carlmegens/knekelbeen/case/base_left.png

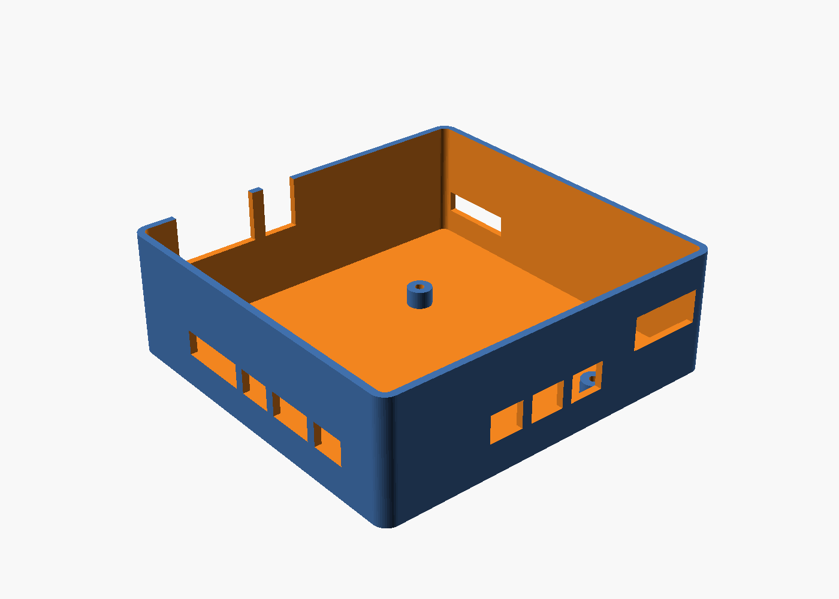
case/base_left.png
