carlmegens/knekelbeen/case/base_top.png

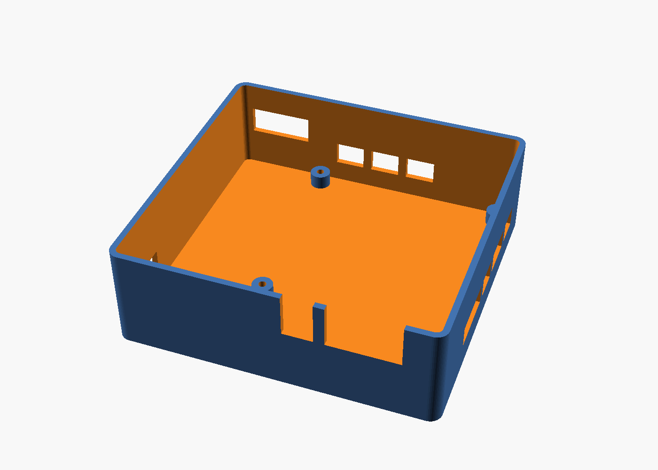
case/base_top.png
