carlmegens/knekelbeen/case/lid_view.png

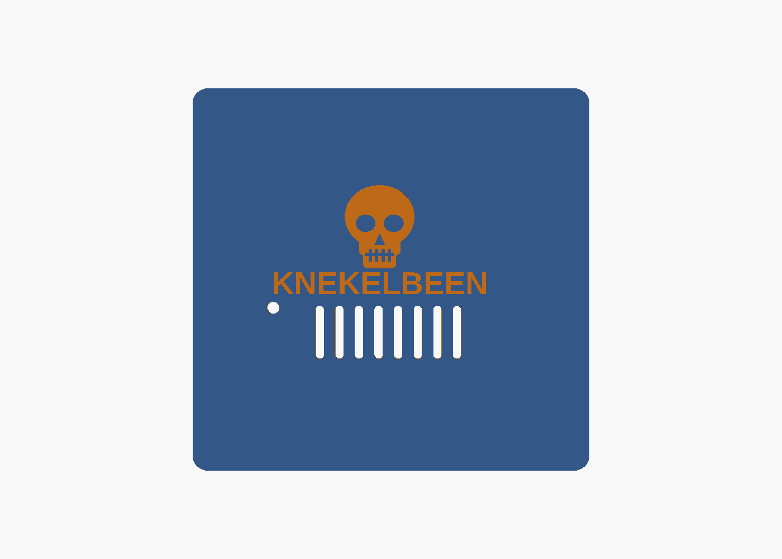
case/lid_view.png
