carlmegens/knekelbeen/kaarsen/Kaarsen_zonder_support_details.png

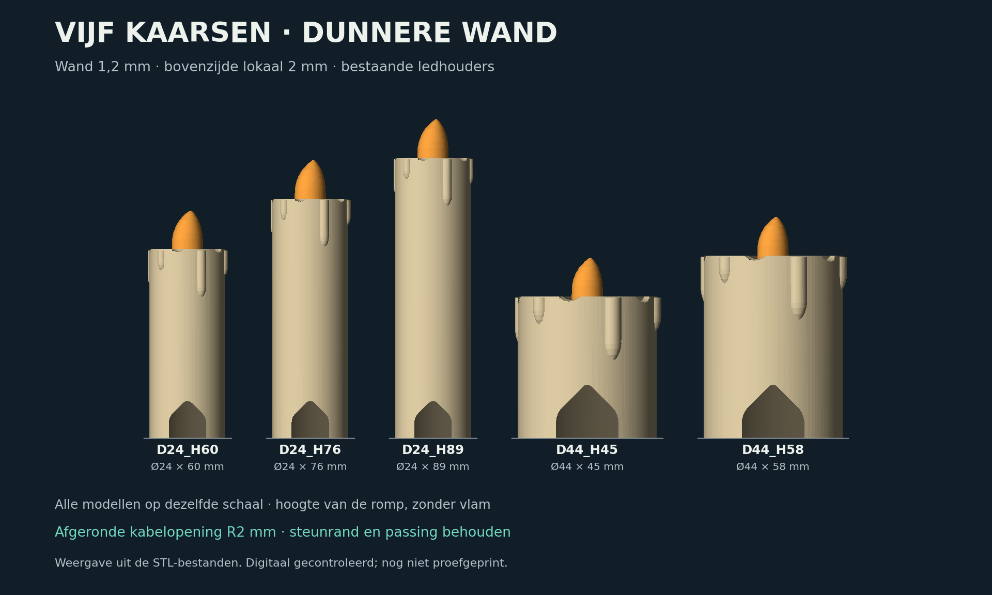
kaarsen/Kaarsen_zonder_support_details.png
