carlmegens/knekelbeen/pcb/out/place.png

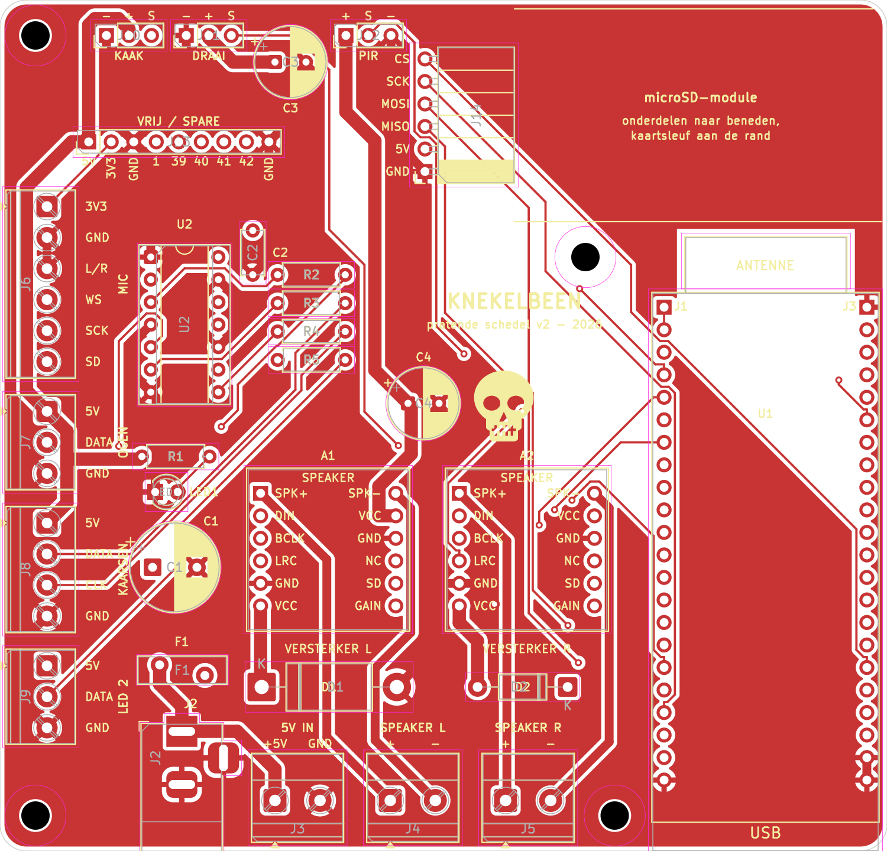
pcb/out/place.png
