carlmegens/knekelbeen/pcb/out/render_black_bottom.png

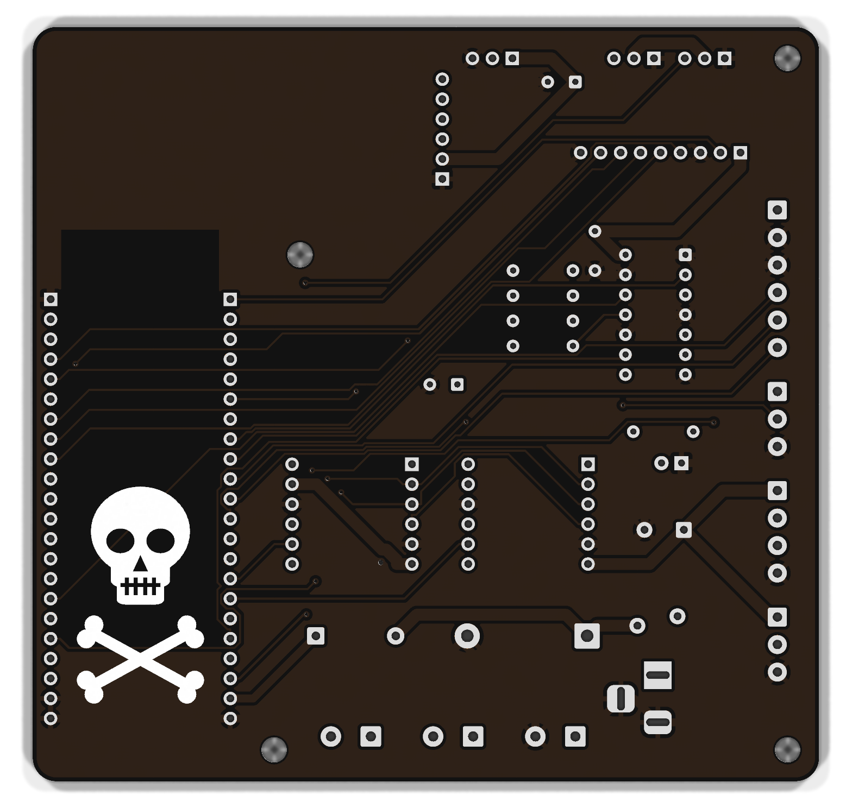
pcb/out/render_black_bottom.png
