carlmegens/knekelbeen/pcb/out/render_black_top.png

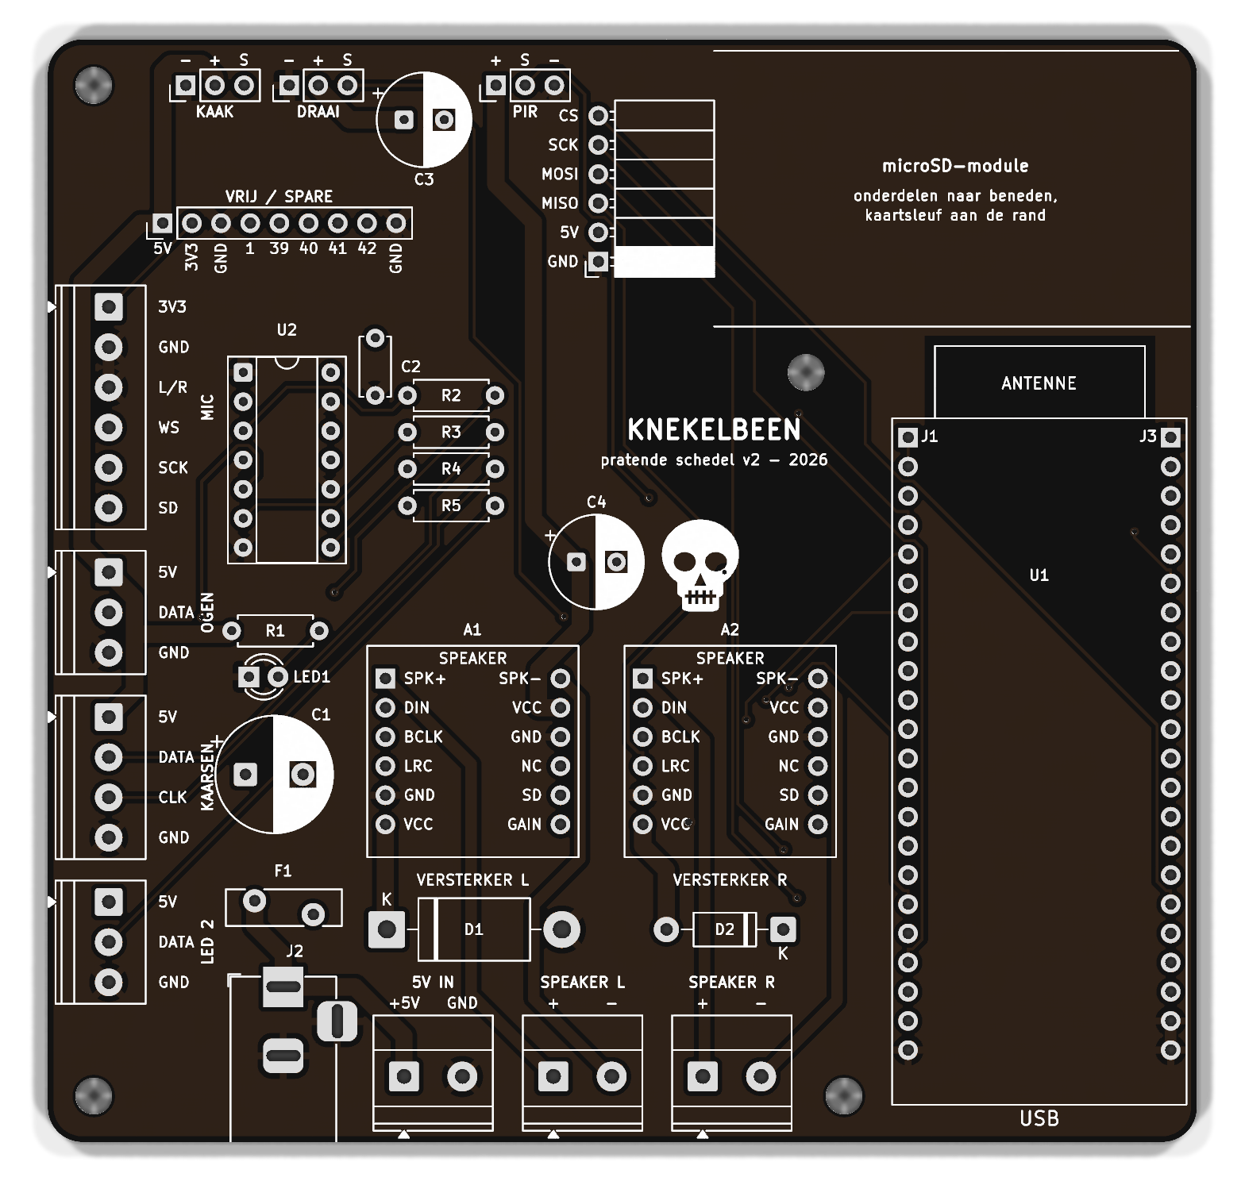
pcb/out/render_black_top.png
