carlmegens/knekelbeen/pcb/out/route_B.png

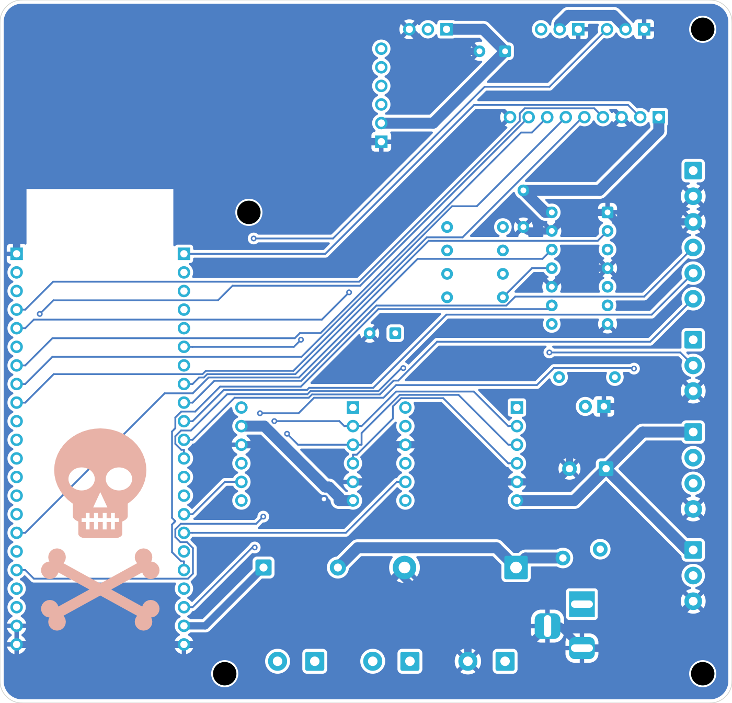
pcb/out/route_B.png
