carlmegens/knekelbeen/case/base.stl

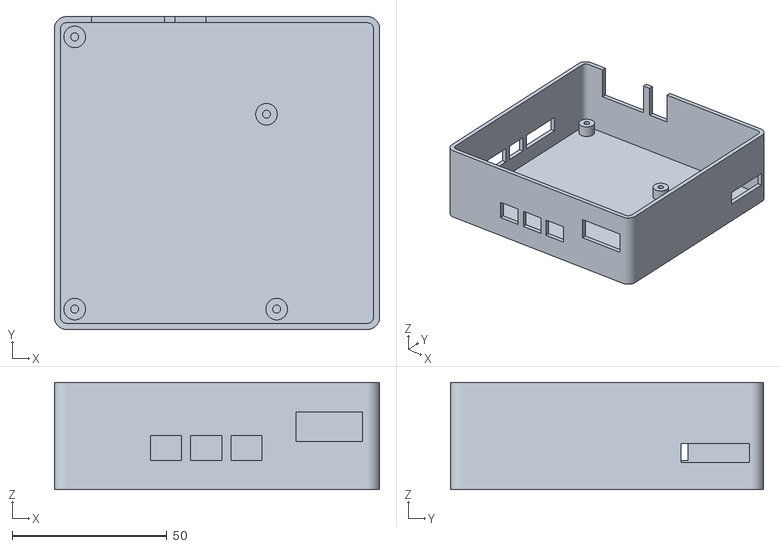
[picture p11: CAD file, 2026-10-13]
case/base.stl
105.2 x 101.2 x 34.6
