carlmegens/knekelbeen/kaarsen/assemblages/kaars_D24_H60_compleet.step

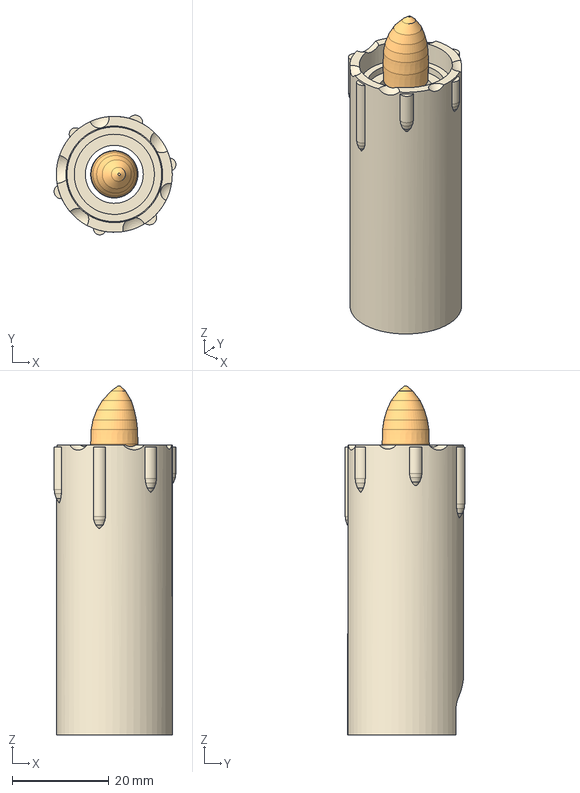
[picture p12: CAD file, 2026-10-21]
kaarsen/assemblages/kaars_D24_H60_compleet.step
25.2 x 24.8 x 72.2 mm
Kaarslichaam
Ledhouder_D24_12mm
Vlamkapje_7p9mm
