carlmegens/knekelbeen/kaarsen/onderdelen/step/vlam_ledtip_7p9mm.step

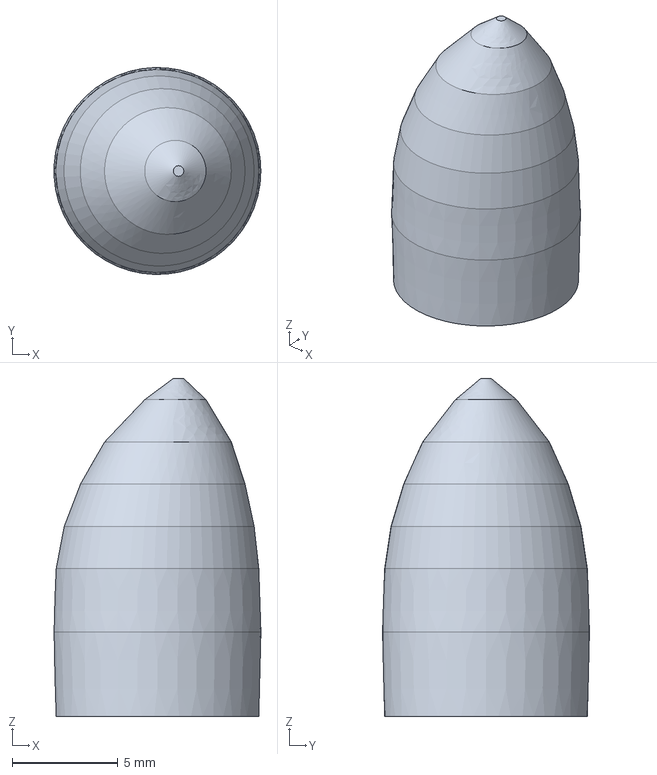
[picture p13: CAD file, 2026-10-21]
kaarsen/onderdelen/step/vlam_ledtip_7p9mm.step
9.79 x 9.80 x 16.0 mm
