carlmegens/knekelbeen/kaarsen/step/kaars_D24_H60.step

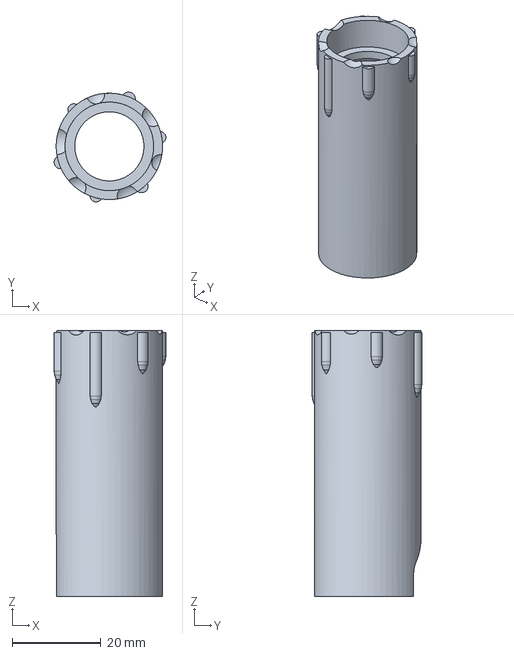
[picture p14: CAD file, 2026-10-21]
kaarsen/step/kaars_D24_H60.step
25.2 x 24.8 x 60.0 mm
