carlmegens/knekelbeen/nek/knekelbeen_nek.step

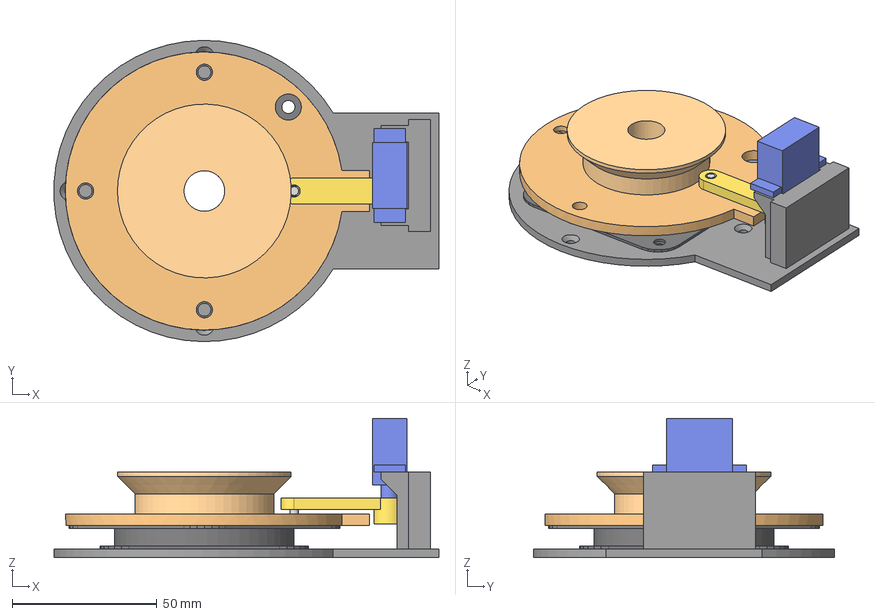
[picture p15: CAD file, 2026-10-26]
nek/knekelbeen_nek.step
132.9 x 104.0 x 48.0 mm
