carlmegens/knekelbeen/nek/stl/schijf_afstandhouder_14_5mm.stl

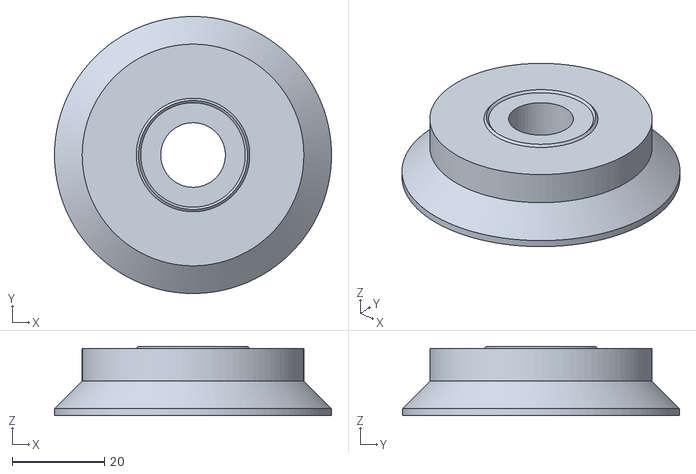
[picture p16: CAD file, 2026-10-26]
nek/stl/schijf_afstandhouder_14_5mm.stl
60.0 x 60.0 x 15.0
