carlmegens/knekelbeen/case/lid.stl

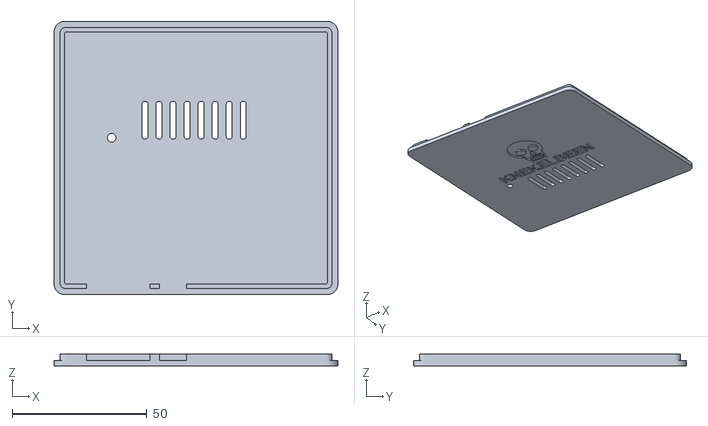
[picture p17: CAD file, 2026-10-13]
case/lid.stl
105.2 x 101.2 x 4.50
