carlmegens/knekelbeen/kaarsen/step/kaars_D44_H45.step

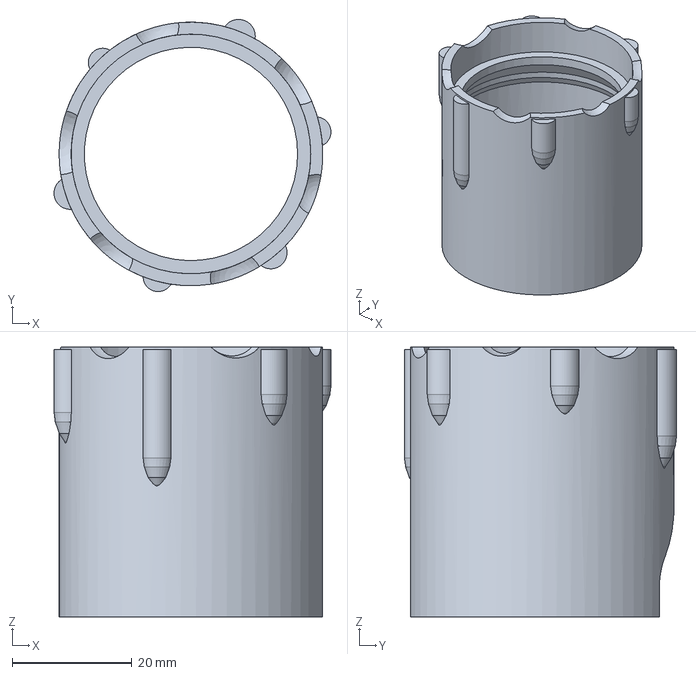
[picture p19: CAD file, 2026-10-21]
kaarsen/step/kaars_D44_H45.step
46.2 x 45.4 x 45.0 mm
