carlmegens/knekelbeen/nek/stl/base.stl

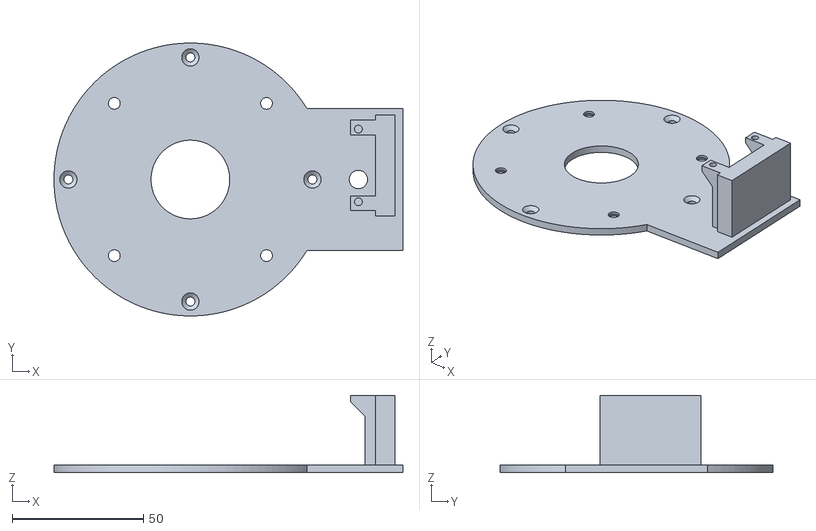
[picture p20: CAD file, 2026-10-26]
nek/stl/base.stl
133.0 x 104.0 x 29.5
