carlmegens/knekelbeen/kaarsen/onderdelen/step/ledhouder_D24_gat12mm.step

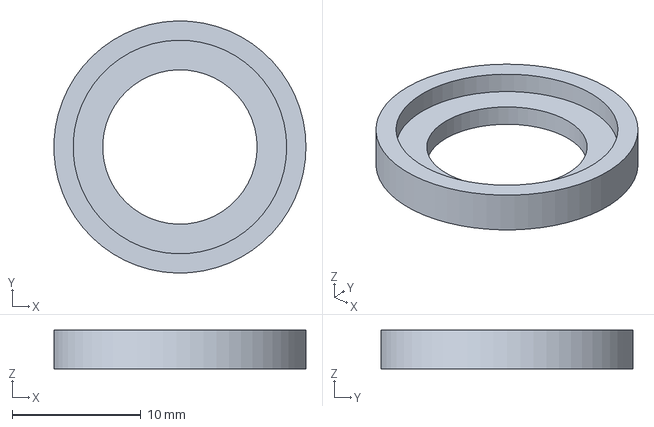
[picture p22: CAD file, 2026-10-21]
kaarsen/onderdelen/step/ledhouder_D24_gat12mm.step
19.6 x 19.6 x 3.00 mm
