carlmegens/knekelbeen/kaarsen/step/kaars_D44_H58.step

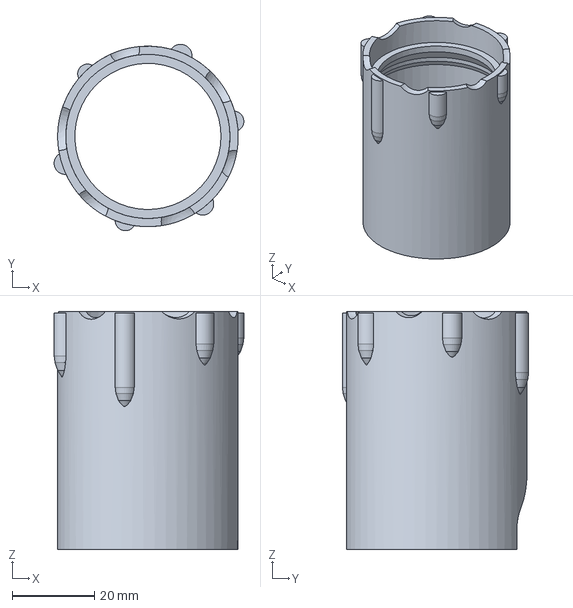
[picture p23: CAD file, 2026-10-21]
kaarsen/step/kaars_D44_H58.step
46.2 x 45.4 x 58.0 mm
