carlmegens/knekelbeen/nek/stl/cap.stl

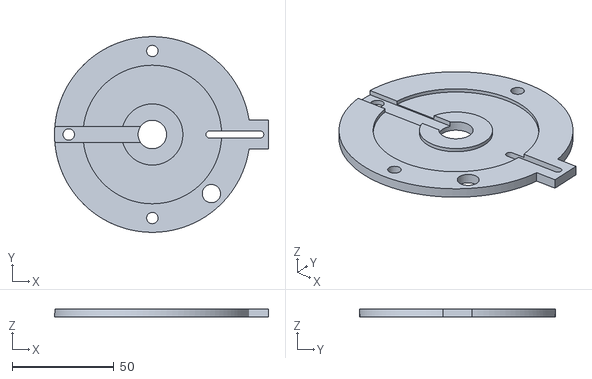
[picture p24: CAD file, 2026-10-26]
nek/stl/cap.stl
105.0 x 96.0 x 4.00
