carlmegens/knekelbeen/kaarsen/assemblages/kaars_D44_H58_compleet.step

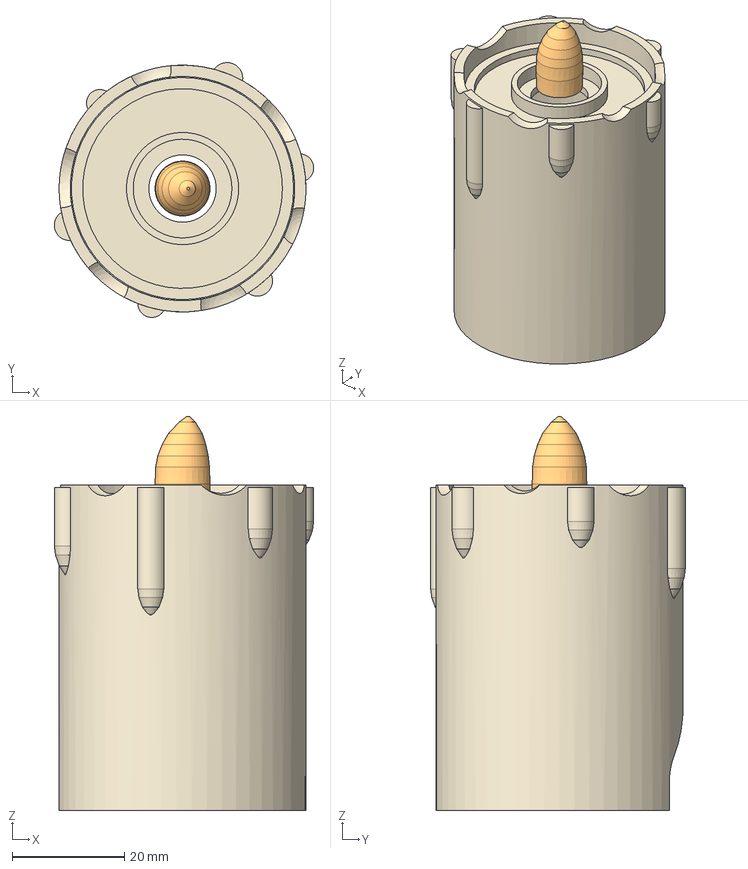
[picture p25: CAD file, 2026-10-21]
kaarsen/assemblages/kaars_D44_H58_compleet.step
46.2 x 45.4 x 70.2 mm
Kaarslichaam
Ledhouder_D44_12mm
Vlamkapje_7p9mm
