carlmegens/knekelbeen/kaarsen/onderdelen/step/ledhouder_D44_gat12mm.step

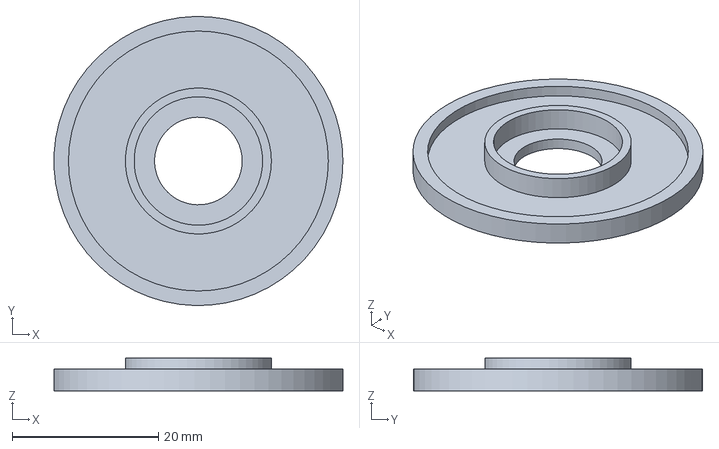
[picture p26: CAD file, 2026-10-21]
kaarsen/onderdelen/step/ledhouder_D44_gat12mm.step
39.6 x 39.6 x 4.50 mm
