carlmegens/knekelbeen/kaarsen/step/kaars_D24_H76.step

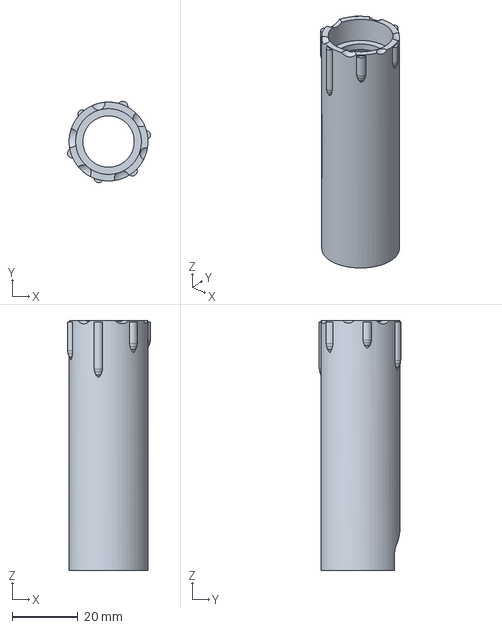
[picture p27: CAD file, 2026-10-21]
kaarsen/step/kaars_D24_H76.step
25.2 x 24.8 x 76.0 mm
