carlmegens/knekelbeen/nek/stl/spline_fit_test.stl

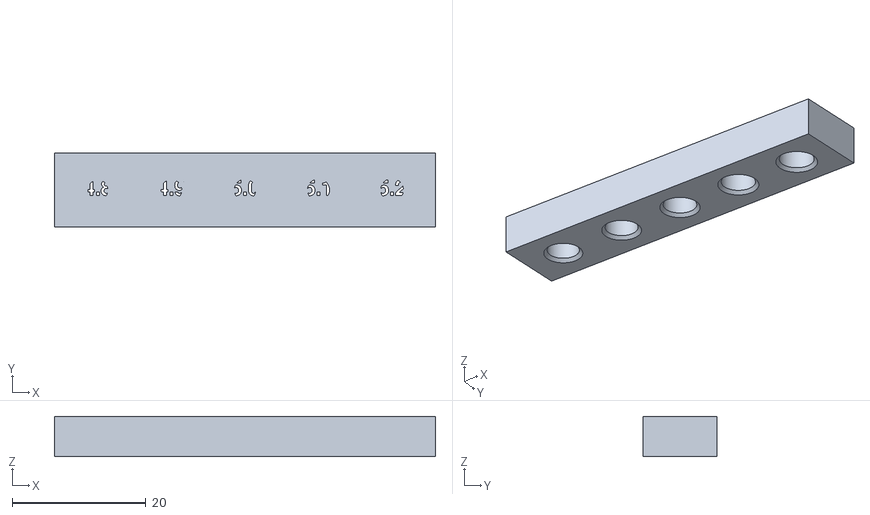
[picture p28: CAD file, 2026-10-26]
nek/stl/spline_fit_test.stl
57.0 x 11.0 x 6.00
