carlmegens/knekelbeen/kaarsen/step/kaars_D24_H89.step

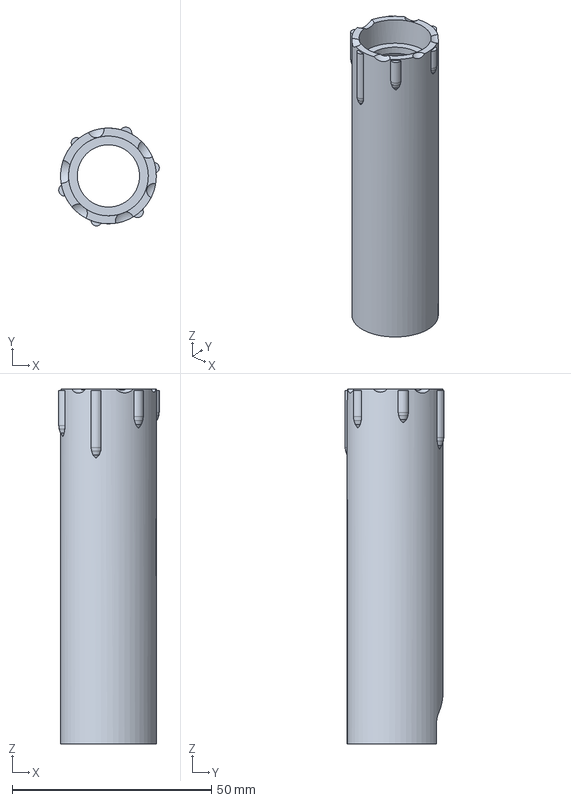
[picture p30: CAD file, 2026-10-21]
kaarsen/step/kaars_D24_H89.step
25.2 x 24.8 x 89.0 mm
