carlmegens/knekelbeen/nek/stl/servo_arm.stl

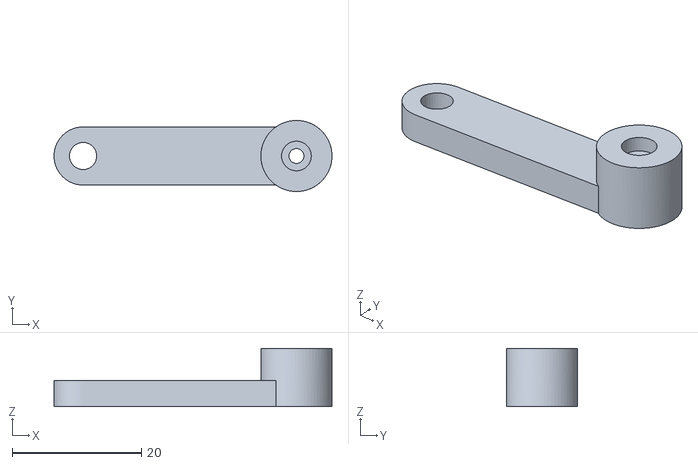
[picture p31: CAD file, 2026-10-26]
nek/stl/servo_arm.stl
43.0 x 11.0 x 9.00
