carlmegens/knekelbeen/nek/stl/vloer_afstandhouder_29_5mm.stl

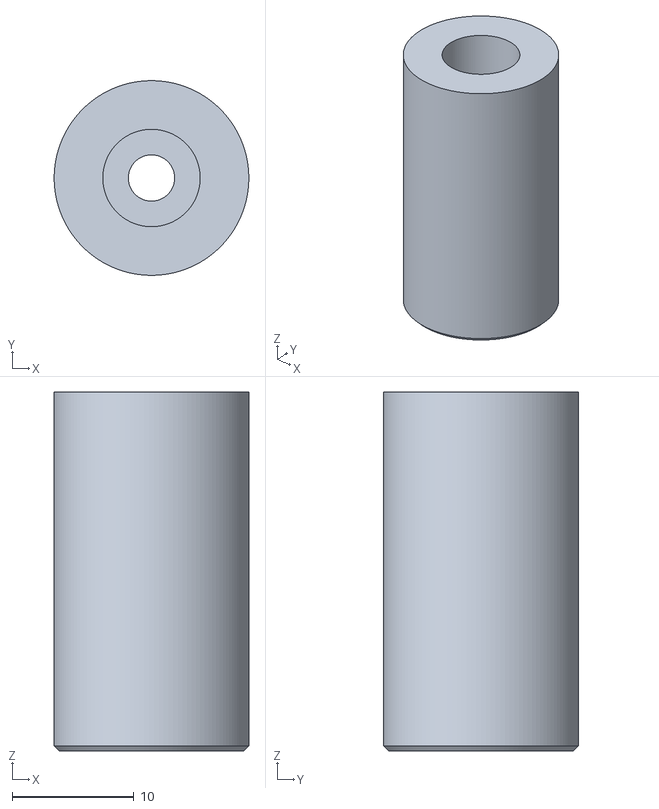
[picture p32: CAD file, 2026-10-26]
nek/stl/vloer_afstandhouder_29_5mm.stl
16.0 x 16.0 x 29.5
