carlmegens/knekelbeen/(list of files, cad)

Other CAD files:
kaarsen/onderdelen/step/vlam_ledtip_7p8mm.step
kaarsen/onderdelen/stl/ledhouder_D24_gat12mm.stl
kaarsen/onderdelen/stl/ledhouder_D44_gat12mm.stl
kaarsen/onderdelen/stl/vlam_ledtip_7p8mm.stl
kaarsen/onderdelen/stl/vlam_ledtip_7p9mm.stl
kaarsen/stl/kaars_D24_H60.stl
kaarsen/stl/kaars_D24_H76.stl
kaarsen/stl/kaars_D24_H89.stl
kaarsen/stl/kaars_D44_H45.stl
kaarsen/stl/kaars_D44_H58.stl
nek/knekelbeen_nek.f3d
