carlmegens/knekelbeen/case/assembly.png

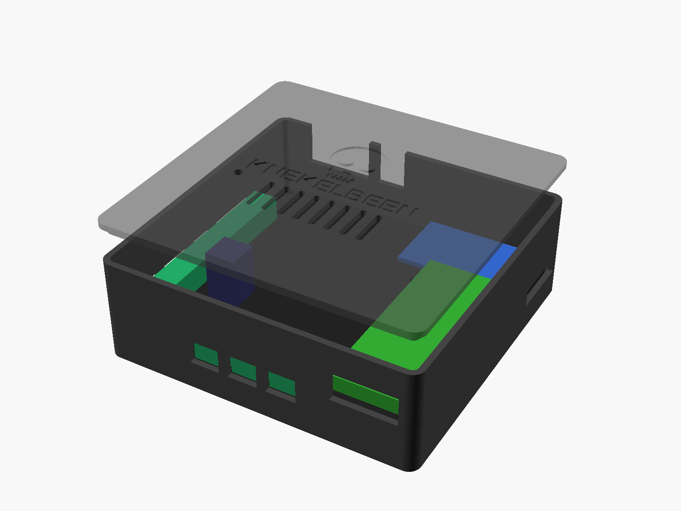
case/assembly.png
