carlmegens/knekelbeen/(list of files, drawings)

Other design files:
pcb/out/skull.dsn
