carlmegens/knekelbeen/pcb/out/unrouted.kicad_pcb

## KiCad design pcb/out/unrouted.kicad_pcb (2026-10-13)

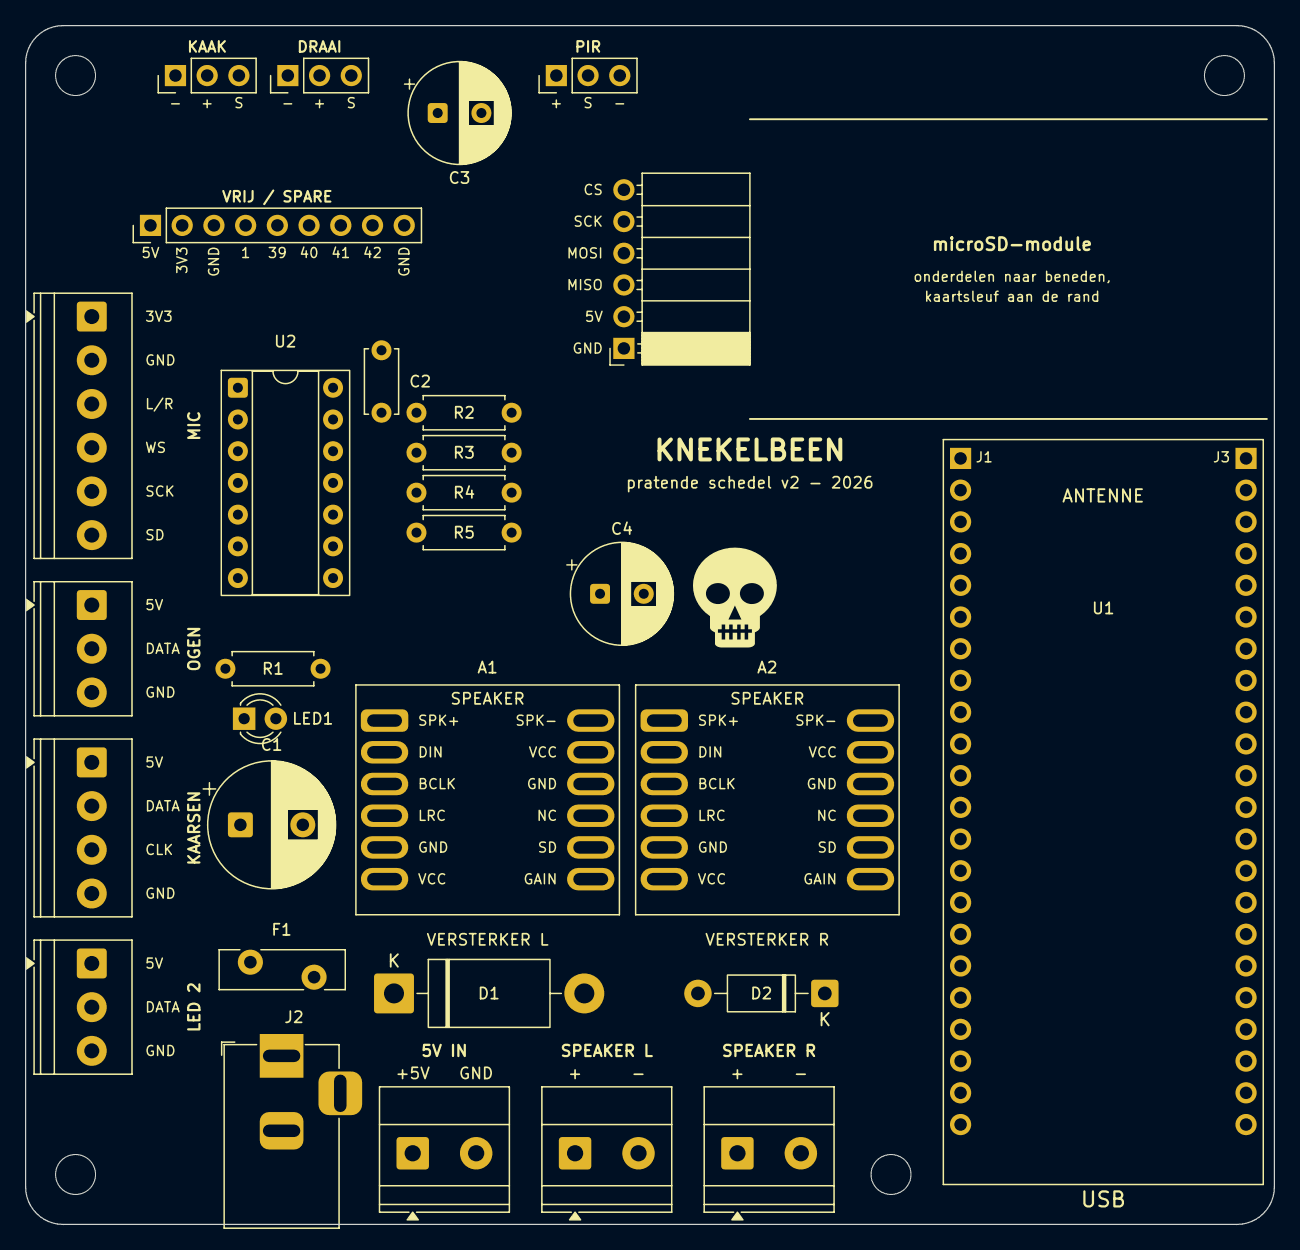
[picture p34: board unrouted.kicad_pcb from above]

Board: 2 copper layers, 100.0 x 96.0 mm, 34 parts (0 on the bottom side), 42 nets, no tracks yet.

Parts:
A1, A2: DFR0954
C1: 1000uF 10V; CP_Radial_D10.0mm_P5.00mm
C2: 100nF; C_Disc_D5.0mm_W2.5mm_P5.00mm
C3, C4: 470uF 10V; CP_Radial_D8.0mm_P3.50mm
D1: 1N5822; D_DO-201AD_P15.24mm_Horizontal
D2: 1N5817; D_DO-41_SOD81_P10.16mm_Horizontal
F1: PTC 4A (MF-RG400); Fuse_Bourns_MF-RG400
H1, H2, H3, H4: M3; MountingHole_3.2mm_M3
J2: DC 5.5x2.1; BarrelJack_Horizontal
J3: 5V IN; TerminalBlock_Phoenix_MKDS-1,5-2-5.08_1x02_P5.08mm_Horizont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
J4: SPEAKER L; TerminalBlock_Phoenix_MKDS-1,5-2-5.08_1x02_P5.08mm_Horizont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
J5: SPEAKER R; TerminalBlock_Phoenix_MKDS-1,5-2-5.08_1x02_P5.08mm_Horizont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
J6: MIC; TerminalBlock_Phoenix_PT-1,5-6-3.5-H_1x06_P3.50mm_Horizontal
J7: OGEN; TerminalBlock_Phoenix_PT-1,5-3-3.5-H_1x03_P3.50mm_Horizontal
J8: KAARSEN; TerminalBlock_Phoenix_PT-1,5-4-3.5-H_1x04_P3.50mm_Horizontal
J9: LED 2; TerminalBlock_Phoenix_PT-1,5-3-3.5-H_1x03_P3.50mm_Horizontal
J10: SERVO KAAK; PinHeader_1x03_P2.54mm_Vertical
J11: SERVO DRAAI; PinHeader_1x03_P2.54mm_Vertical
J12: PIR; PinHeader_1x03_P2.54mm_Vertical
J13: VRIJ; PinHeader_1x09_P2.54mm_Vertical
J14: SD-KAART; PinSocket_1x06_P2.54mm_Horizontal
LED1: groen; LED_D3.0mm
R1: 1k; R_Axial_DIN0207_L6.3mm_D2.5mm_P7.62mm_Horizontal
R2, R3, R4, R5: 330; R_Axial_DIN0207_L6.3mm_D2.5mm_P7.62mm_Horizontal
U1: ESP32-S3-DevKitC-1
U2: 74AHCT125N; DIP-14_W7.62mm_Socket

Connections:
+3V3: J6.1, J13.2, U1.1, U1.2
+5V: A1.6, A1.8, A2.6, A2.8, C1.1, C2.1, C3.1, C4.1, D1.1, D2.2, F1.2, J7.1, J8.1, J9.1, J10.2, J11.2, J12.1, J13.1, J14.2, R1.1, U2.14
CANDLE_CLK: J8.3, R4.2
CANDLE_DATA: J8.2, R3.2
CCLK_5V: R4.1, U2.8
CDATA_5V: R3.1, U2.6
ESP5V: D2.1, U1.21
EYES_5V: R2.1, U2.3
EYES_DATA: J7.2, R2.2
GND: A1.5, A1.9, A2.5, A2.9, C1.2, C2.2, C3.2, C4.2, D1.2, J2.2, J2.3, J3.2, J6.2, J6.3, J7.3, J8.4, J9.3, J10.1, J11.1, J12.3, J13.3, J13.9, J14.1, LED1.1, U1.22, U1.23, U1.43, U1.44, U2.1, U2.4, U2.7, U2.10, U2.13
IO1: J13.4, U1.26
IO2: J12.2, U1.27
IO4: J10.3, U1.4
IO5: A1.3, A2.3, U1.5
IO6: A1.4, A2.4, U1.6
IO7: A1.2, A2.2, U1.7
IO8: J11.3, U1.12
IO9: A2.11, U1.15
IO10: A1.11, U1.16
IO11: U1.17, U2.5
IO12: U1.18, U2.9
IO13: J14.5, U1.19
IO14: J14.3, U1.20
IO15: U1.8, U2.2
IO16: J6.4, U1.9
IO17: J6.5, U1.10
IO18: J6.6, U1.11
IO21: J14.4, U1.40
IO39: J13.5, U1.31
IO40: J13.6, U1.30
IO41: J13.7, U1.29
IO42: J13.8, U1.28
IO47: J14.6, U1.39
IO48: U1.38, U2.12
LED2_5V: R5.1, U2.11
LED2_DATA: J9.2, R5.2
PWR_LED: LED1.2, R1.2
SPK_L+: A1.1, J4.1
SPK_L-: A1.7, J4.2
SPK_R+: A2.1, J5.1
SPK_R-: A2.7, J5.2
VIN: F1.1, J2.1, J3.1
