carlmegens/knekelbeen/firmware/src/main.cpp

#include <Arduino.h>
#include <ArduinoOTA.h>
#include <ESPmDNS.h>
#include <WebServer.h>
#include <WiFi.h>

#include "audio.h"
#include "config.h"
#include "candles.h"
#include "eyes.h"
#include "mic.h"
#include "jaw.h"
#include "led2.h"
#include "pir.h"
#include "scene.h"
#include "smoke.h"
#include "storage.h"
#include "turn.h"

#if __has_include("secrets.h")
#include "secrets.h"
#else
#define WIFI_SSID ""
#define WIFI_PASSWORD ""
#endif

static WebServer server(80);
static String brainUrl;  // laptop app, announced by itself every 30 s

static void ghost() {
  candles::trigger(candles::GHOST);
  eyes::tint(0x28FF5A, 6000);  // the eyes turn the same eerie green
}

// Light cues inside a clip; the same names as the AI's speciaal_effect.
static void lightCue(const char *name) {
  scene::note(name);  // the laptop lets the outdoor lamps join in
  if (!strcmp(name, "kaarsen_op")) candles::trigger(candles::FLARE);
  else if (!strcmp(name, "kaarsen_uit")) candles::trigger(candles::BLOW_OUT);
  else if (!strcmp(name, "spookgroen")) ghost();
  else if (!strcmp(name, "ogen_flits")) eyes::flash();
  else if (!strcmp(name, "bliksem")) scene::strike();
  else if (!strcmp(name, "donder")) scene::thunder();
  else if (!strcmp(name, "rook")) smoke::puff(false);
  else if (!strcmp(name, "veel_rook")) smoke::puff(true);
  else if (!strcmp(name, "snoep")) led2::candy();
}

// Smoke takes a moment to come out of the machine; press the button earlier.
static int cueLead(const char *name) {
  return !strcmp(name, "rook") || !strcmp(name, "veel_rook") ? smoke::leadMs() : 0;
}

// web/index.html, embedded at build time (board_build.embed_txtfiles).
extern const char PAGE[] asm("_binary_web_index_html_start");

static void setupWifi() {
  WiFi.setHostname(HOSTNAME);
  if (strlen(WIFI_SSID)) {
    WiFi.mode(WIFI_STA);
    // Mesh/multi-AP: scan every channel and join the strongest AP, instead of
    // the first one found (the default).
    WiFi.setScanMethod(WIFI_ALL_CHANNEL_SCAN);
    WiFi.setSortMethod(WIFI_CONNECT_AP_BY_SIGNAL);
    WiFi.begin(WIFI_SSID, WIFI_PASSWORD);
    Serial.printf("Connecting to %s", WIFI_SSID);
    for (int i = 0; i < 40 && WiFi.status() != WL_CONNECTED; i++) {
      delay(250);
      Serial.print('.');
    }
    Serial.println();
    if (WiFi.status() != WL_CONNECTED)
      Serial.printf("WiFi failed (status %d) - is it a 2.4 GHz network?\n",
                    WiFi.status());
  }
  if (WiFi.status() == WL_CONNECTED) {
    Serial.printf("WiFi OK: http://%s  (http://%s.local)\n",
                  WiFi.localIP().toString().c_str(), HOSTNAME);
  } else {
    WiFi.mode(WIFI_AP);
    WiFi.softAP(AP_SSID, AP_PASSWORD);
    Serial.printf("AP mode: join '%s' / '%s', open http://%s\n", AP_SSID,
                  AP_PASSWORD, WiFi.softAPIP().toString().c_str());
  }
  WiFi.setSleep(false);  // lower latency for later audio streaming
  MDNS.begin(HOSTNAME);
  MDNS.addService("http", "tcp", 80);
}

static void setupServer() {
  server.on("/", [] { server.send(200, "text/html; charset=utf-8", PAGE); });

  server.on("/jaw", [] {
    if (server.hasArg("on")) jaw::setOn(server.arg("on") == "1");
    if (server.hasArg("soft")) jaw::setSoftness(server.arg("soft").toInt());
    if (server.hasArg("pos")) jaw::setTarget(server.arg("pos").toFloat() / 100.0f);
    server.send(200, "application/json", String("{\"on\":") + (jaw::isOn() ? "true" : "false") +
                                                 ",\"soft\":" + jaw::softness() + "}");
  });

  server.on("/chatter", [] {
    uint32_t ms = server.hasArg("ms") ? server.arg("ms").toInt() : 3000;
    jaw::chatter(ms);
    server.send(200, "text/plain", "ok");
  });

  // Direct servo angle for calibration; cleared by the next jaw command.
  server.on("/raw", [] {
    jaw::setRawDeg(server.arg("deg").toInt());
    server.send(200, "text/plain", "ok");
  });

  server.on("/cal", [] {
    if (server.hasArg("closed") && server.hasArg("open")) {
      jaw::setCalibration(server.arg("closed").toInt(),
                          server.arg("open").toInt());
      jaw::setTarget(0);
    }
    server.send(200, "application/json",
                String("{\"closed\":") + jaw::closedDeg() +
                    ",\"open\":" + jaw::openDeg() + "}");
  });

  server.on("/random", [] {
    bool ok = audio::playRandom();
    server.send(ok ? 200 : 404, "text/plain", ok ? "ok" : "no clips");
  });

  server.on("/play", [] {
    String f = "/clips/" + server.arg("f");
    if (!audio::isValidWav(f)) {  // missing, empty or not a playable WAV
      server.send(415, "text/plain", "not a playable WAV");
      return;
    }
    server.send(audio::playFile(f) ? 200 : 404, "text/plain", "ok");
  });

  server.on("/tone", [] {
    audio::playTone();
    server.send(200, "text/plain", "ok");
  });

  server.on("/pins", [] {
    if (server.hasArg("bclk"))
      audio::setPins(server.arg("bclk").toInt(), server.arg("lrc").toInt(),
                     server.arg("din").toInt());
    server.send(200, "application/json", audio::pins());
  });

  server.on("/stop", [] {
    audio::stop();
    server.send(200, "text/plain", "ok");
  });

  server.on("/volume", [] {
    audio::setVolume(server.arg("v").toInt());
    server.send(200, "text/plain", "ok");
  });

  server.on("/sync", [] {
    if (server.hasArg("gate"))
      audio::setSync({(int)server.arg("gate").toInt(),
                      (int)server.arg("sens").toInt(),
                      (int)server.arg("lead").toInt()});
    audio::Sync s = audio::sync();
    server.send(200, "application/json",
                String("{\"gate\":") + s.gate + ",\"sens\":" + s.sensitivity +
                    ",\"lead\":" + s.leadMs + ",\"vol\":" + audio::volume() +
                    "}");
  });

  server.on("/clips", [] {
    String json = "{\"clips\":[";
    File dir = storage::clips().open("/clips");
    bool first = true;
    for (File f = dir.openNextFile(); f; f = dir.openNextFile()) {
      if (!first) json += ',';
      first = false;
      json += String("{\"name\":\"") + f.name() + "\",\"size\":" + f.size() + "}";
    }
    json += "]," + storage::json() + "}";
    server.send(200, "application/json", json);
  });

  server.on("/delete", [] {
    String name = server.arg("f");
    bool ok = name.length() && name.indexOf('/') < 0 &&
              storage::clips().remove("/clips/" + name);
    server.send(ok ? 200 : 404, "text/plain", ok ? "ok" : "not found");
  });

  // Multipart upload into /clips (curl -F f=@hello.wav http://skull/upload)
  // 200 = ok, 415 = not a playable WAV, 507 = storage full.
  static File uploadFile;
  static String uploadPath;
  static bool uploadFull;
  server.on(
      "/upload", HTTP_POST,
      [] {
        if (uploadFile) uploadFile.close();  // make sure it can be removed
        if (uploadFull) {
          storage::clips().remove(uploadPath);
          server.send(507, "text/plain", "storage full");
        } else if (!audio::isValidWav(uploadPath)) {
          storage::clips().remove(uploadPath);
          server.send(415, "text/plain", "not a 16-bit PCM WAV");
        } else {
          server.send(200, "text/plain", "ok");
        }
      },
      [] {
        HTTPUpload &up = server.upload();
        if (up.status == UPLOAD_FILE_START) {
          String name = up.filename;
          name = name.substring(name.lastIndexOf('/') + 1);
          uploadPath = "/clips/" + name;
          uploadFull = false;
          uploadFile = storage::clips().open(uploadPath, "w");
          if (!uploadFile) uploadFull = true;
          Serial.printf("Upload %s\n", name.c_str());
        } else if (up.status == UPLOAD_FILE_WRITE && uploadFile) {
          if (uploadFile.write(up.buf, up.currentSize) != up.currentSize)
            uploadFull = true;
        } else if (up.status == UPLOAD_FILE_END && uploadFile) {
          uploadFile.close();
          Serial.printf("Upload done, %u bytes\n", up.totalSize);
        } else if (up.status == UPLOAD_FILE_ABORTED && uploadFile) {
          uploadFile.close();
          uploadFull = true;
        }
      });

  server.on("/eyes", [] {
    if (server.hasArg("color"))
      eyes::set(strtoul(server.arg("color").c_str(), nullptr, 16),
                server.arg("bright").toInt(),
                (eyes::Mode)server.arg("mode").toInt());
    if (server.hasArg("on")) eyes::setOn(server.arg("on") == "1");
    if (server.hasArg("flash")) eyes::flash();
    char buf[80];
    snprintf(buf, sizeof buf, "{\"on\":%s,\"color\":\"%06X\",\"bright\":%d,\"mode\":%d}",
             eyes::isOn() ? "true" : "false", (unsigned)eyes::color(), eyes::brightness(),
             (int)eyes::mode());
    server.send(200, "application/json", buf);
  });

  server.on("/candles", [] {
    if (server.hasArg("count"))
      candles::configure(server.arg("count").toInt(), server.arg("order"),
                         server.arg("bright").toInt(),
                         (candles::Mode)server.arg("mode").toInt());
    if (server.hasArg("on")) candles::setOn(server.arg("on") == "1");
    if (server.hasArg("speed")) candles::setSpeed(server.arg("speed").toInt());
    if (server.hasArg("voice")) candles::setVoiceReact(server.arg("voice") == "1");
    if (server.hasArg("visit")) candles::setVisitBright(server.arg("visit").toInt());
    String fx = server.arg("effect");
    if (fx == "out") lightCue("kaarsen_uit");
    else if (fx == "flare") lightCue("kaarsen_op");
    else if (fx == "ghost") lightCue("spookgroen");
    else if (fx == "test") candles::trigger(candles::TEST);
    else if (fx == "strike") lightCue("bliksem");
    else if (fx == "thunder") lightCue("donder");
    server.send(200, "application/json", candles::json());
  });

  // The laptop app announces itself here so this page can reach the AI.
  server.on("/brain", [] {
    String url = server.arg("url");
    if (url.startsWith("http://") && url.length() < 80 && url.indexOf('"') < 0)
      brainUrl = url;
    server.send(200, "text/plain", brainUrl);
  });

  // Turn servo: pos -100..100, or deg= for a raw angle (calibration), or
  // on/center/range/lively to configure.
  server.on("/turn", [] {
    if (server.hasArg("center"))
      turn::setConfig(server.arg("on") == "1", server.arg("center").toInt(),
                      server.arg("range").toInt(), server.arg("lively") == "1");
    if (server.hasArg("deg")) turn::setRawDeg(server.arg("deg").toInt());
    if (server.hasArg("pos")) turn::setTarget(server.arg("pos").toFloat() / 100.0f);
    server.send(200, "application/json", turn::json());
  });

  server.on("/pir", [] {
    if (server.hasArg("on"))
      pir::setConfig(server.arg("on") == "1", server.arg("cooldown").toInt());
    if (server.hasArg("test")) pir::test();
    server.send(200, "application/json", pir::json());
  });

  server.on("/smoke", [] {
    if (server.hasArg("host"))
      smoke::setConfig(server.arg("on") == "1", server.arg("host"), server.arg("cooldown").toInt(),
                       server.arg("small").toFloat() * 1000, server.arg("big").toFloat() * 1000,
                       server.hasArg("lead") ? server.arg("lead").toFloat() * 1000 : smoke::leadMs());
    // puff=small|big respects the cooldown; test=small|big doesn't.
    if (server.hasArg("puff")) smoke::puff(server.arg("puff") == "big");
    if (server.hasArg("test")) smoke::puff(server.arg("test") == "big", true);
    server.send(200, "application/json", smoke::json());
  });

  // A clip's lights without its sound, e.g. with the doorbell's own organ.
  server.on("/lights", [] {
    bool ok = audio::lightsOnly("/clips/" + server.arg("f"));
    if (ok) scene::visit();  // whoever rings is at the door
    server.send(ok ? 200 : 404, "text/plain", ok ? "ok" : "geen clip met lichteffecten");
  });

  // Someone at the door (the laptop sends this for Home Assistant's sensors);
  // hold= sets how long a visit lasts after the last sign.
  server.on("/visit", [] {
    if (server.hasArg("hold")) scene::setHold(server.arg("hold").toInt());
    if (server.hasArg("now")) scene::visit();
    server.send(200, "application/json", scene::json());
  });

  server.on("/led2", [] {
    if (server.hasArg("on")) led2::setOn(server.arg("on") == "1");
    if (server.hasArg("color"))
      led2::set(server.arg("count").toInt(),
                strtoul(server.arg("color").c_str(), nullptr, 16),
                server.arg("bright").toInt(), (led2::Mode)server.arg("mode").toInt());
    if (server.hasArg("vcolor"))
      led2::setVisit(strtoul(server.arg("vcolor").c_str(), nullptr, 16),
                     server.arg("vbright").toInt(), (led2::Mode)server.arg("vmode").toInt());
    if (server.hasArg("fx")) led2::setEffects(server.arg("fx") == "1");
    if (server.hasArg("bcount"))
      led2::setBowl(server.arg("bcount").toInt(), strtoul(server.arg("bcolor").c_str(), nullptr, 16),
                    server.arg("bbright").toInt(), (led2::Mode)server.arg("bmode").toInt(),
                    strtoul(server.arg("ccolor").c_str(), nullptr, 16), server.arg("csecs").toInt() * 1000);
    if (server.hasArg("pcount"))
      led2::setPumpkin(server.arg("pcount").toInt(), strtoul(server.arg("pcolor").c_str(), nullptr, 16),
                       server.arg("pbright").toInt(), (led2::Mode)server.arg("pmode").toInt(),
                       strtoul(server.arg("pvcolor").c_str(), nullptr, 16),
                       server.arg("pvbright").toInt(), (led2::Mode)server.arg("pvmode").toInt(),
                       server.arg("pfx") == "1");
    if (server.hasArg("candy")) led2::candy();
    server.send(200, "application/json", led2::json());
  });

  server.on("/amps", [] {
    if (server.hasArg("on")) audio::setSoundOn(server.arg("on") == "1");
    if (server.hasArg("sleep")) audio::setAmpSleep(server.arg("sleep") == "1");
    if (server.hasArg("bass")) audio::setBassCut(server.arg("bass").toInt());
    if (server.hasArg("echoon") || server.hasArg("echo") || server.hasArg("echoms"))
      audio::setEcho(server.hasArg("echoon") ? server.arg("echoon") == "1" : audio::echoEnabled(),
                     server.hasArg("echo") ? server.arg("echo").toInt() : audio::echo(),
                     server.hasArg("echoms") ? server.arg("echoms").toInt() : audio::echoMs());
    server.send(200, "application/json",
                String("{\"on\":") + (audio::soundIsOn() ? "true" : "false") +
                    ",\"sleep\":" + (audio::ampSleepOn() ? "true" : "false") +
                    ",\"bass\":" + audio::bassCut() + ",\"echoon\":" + (audio::echoEnabled() ? "true" : "false") +
                    ",\"echo\":" + audio::echo() +
                    ",\"echoms\":" + audio::echoMs() + "}");
  });

  server.on("/mic", [] {
    if (server.hasArg("gain")) mic::setGain(server.arg("gain").toInt());
    char buf[128];
    snprintf(buf, sizeof buf,
             "{\"db\":%.1f,\"gain\":%d,\"streaming\":%s,\"slot\":%d,\"peak\":%u}",
             mic::levelDb(), mic::gain(), mic::streaming() ? "true" : "false",
             mic::slot(), (unsigned)mic::peak());
    server.send(200, "application/json", buf);
  });

  server.on("/status", [] {
    server.send(200, "application/json",
                String("{\"playing\":") + (audio::isPlaying() ? "true" : "false") +
                    ",\"live\":" + (audio::isLive() ? "true" : "false") +
                    ",\"brain\":\"" + brainUrl + "\"" +
                    ",\"motion\":" + (pir::motion() ? "true" : "false") +
                    ",\"clip\":\"" + audio::currentClip() + "\"" +
                    ",\"storage\":\"" + storage::name() + "\"}");
  });

  server.begin();
}

static void setupOta() {
  ArduinoOTA.setHostname(HOSTNAME);
  ArduinoOTA.setPassword(OTA_PASSWORD);
  ArduinoOTA.onStart([] { audio::stop(); });
  ArduinoOTA.begin();
}

// Serial: send a number 0-100 to set jaw %, 'c' to chatter.
static void handleSerial() {
  static String line;
  while (Serial.available()) {
    char ch = Serial.read();
    if (ch == '\n' || ch == '\r') {
      line.trim();
      if (line == "c") jaw::chatter(3000);
      else if (line.length()) jaw::setTarget(line.toFloat() / 100.0f);
      line = "";
    } else {
      line += ch;
    }
  }
}

void setup() {
  Serial.begin(115200);
  delay(1500);
  Serial.println("\n=== Talking Skull ===");
  jaw::begin();
  turn::begin();
  scene::begin();
  eyes::begin();
  candles::begin();
  mic::begin();
  storage::begin();
  audio::begin();
  audio::onCue(lightCue, cueLead);
  setupWifi();
  audio::beginNetwork();
  mic::beginNetwork();
  setupServer();
  setupOta();
  pir::begin();
  smoke::begin();
}

// The ESP32 never roams on its own. If the signal stays weak (e.g. it booted
// near another AP), scan in the background and move to a clearly stronger AP
// of the same network. Never while talking, so a conversation isn't cut off.
static void checkRoaming() {
  static uint32_t weakSince = 0, nextTry = 0;
  static bool scanning = false;
  if (WiFi.getMode() != WIFI_STA || WiFi.status() != WL_CONNECTED) return;

  if (scanning) {
    int n = WiFi.scanComplete();
    if (n == WIFI_SCAN_RUNNING) return;
    scanning = false;
    int best = -1, current = WiFi.RSSI();
    for (int i = 0; i < n; i++)
      if (WiFi.SSID(i) == WIFI_SSID && WiFi.BSSIDstr(i) != WiFi.BSSIDstr() &&
          (best < 0 || WiFi.RSSI(i) > WiFi.RSSI(best)))
        best = i;
    if (best >= 0 && WiFi.RSSI(best) >= current + ROAM_MIN_GAIN && !audio::isPlaying()) {
      Serial.printf("Roaming: %d dBm -> %d dBm (%s)\n", current, WiFi.RSSI(best),
                    WiFi.BSSIDstr(best).c_str());
      WiFi.begin(WIFI_SSID, WIFI_PASSWORD, WiFi.channel(best), WiFi.BSSID(best));
    } else {
      nextTry = millis() + ROAM_BACKOFF_MS;  // nothing better around
    }
    WiFi.scanDelete();
    return;
  }

  if (WiFi.RSSI() > ROAM_RSSI || audio::isPlaying()) {
    weakSince = 0;
    return;
  }
  if (!weakSince) weakSince = millis();
  if (millis() - weakSince > ROAM_AFTER_MS && (int32_t)(millis() - nextTry) >= 0) {
    weakSince = 0;
    scanning = WiFi.scanNetworks(true) == WIFI_SCAN_RUNNING;  // async
  }
}

static void printStatus() {
  if (WiFi.getMode() == WIFI_AP)
    Serial.printf("[status] AP '%s' http://%s\n", AP_SSID,
                  WiFi.softAPIP().toString().c_str());
  else
    Serial.printf("[status] WiFi %s (%d) http://%s rssi=%d\n",
                  WiFi.status() == WL_CONNECTED ? "connected" : "DOWN",
                  WiFi.status(), WiFi.localIP().toString().c_str(),
                  WiFi.RSSI());
}

void loop() {
  static uint32_t lastStatus = 0, lastRoam = 0;
  if (millis() - lastRoam > 1000) {
    lastRoam = millis();
    checkRoaming();
  }
  if (millis() - lastStatus > 10000) {
    lastStatus = millis();
    printStatus();
  }
  server.handleClient();
  ArduinoOTA.handle();
  handleSerial();
  audio::tickCues();
  smoke::service();
  delay(1);
}
