carlmegens/knekelbeen/firmware/src/audio.cpp

#include "audio.h"

#include <AsyncUDP.h>
#include <Preferences.h>
#include <driver/i2s.h>

#include <vector>

#include "config.h"
#include "jaw.h"
#include "storage.h"

namespace audio {

static const i2s_port_t PORT = I2S_NUM_0;
static const int DMA_BUFS = 4;
static const int DMA_LEN = 256;  // frames per DMA buffer
static const int MAX_LEAD_BLOCKS = 40;  // 10ms blocks -> up to 400ms

static Preferences prefs;
static TaskHandle_t task = nullptr;
static volatile bool stopFlag = false;
static volatile bool playing = false;
static String pendingPath;
static String currentPath;
static SemaphoreHandle_t pathLock;  // guards pendingPath/currentPath
static volatile int vol = 70;
static Sync cfg = {400, 60, 100};
static volatile bool ampSleep = true;
static uint32_t currentRate = 0;
static int pinBclk = PIN_I2S_BCLK, pinLrc = PIN_I2S_LRC, pinDin = PIN_I2S_DIN;

// ---------- jaw envelope ----------
struct Envelope {
  float env = 0, peak = 0;
  void reset() { env = 0; peak = 4000; }
  float update(const int16_t *s, int n) {
    double acc = 0;
    for (int i = 0; i < n; i++) acc += (double)s[i] * s[i];
    float rms = sqrtf(acc / n);
    env += (rms - env) * (rms > env ? 0.6f : 0.25f);  // fast open, slower close
    peak = fmaxf(env, fmaxf(peak * 0.995f, 2000.0f));
    float full = peak * cfg.sensitivity / 100.0f;
    if (full <= cfg.gate + 1) return 0;
    float open = (env - cfg.gate) / (full - cfg.gate);
    return constrain(open, 0.0f, 1.0f);
  }
};

// ---------- amps ----------
// The amps sleep while nothing plays, so they can't hum or hiss.
static volatile bool soundOn = true;  // off: the amps stay in shutdown

static void ampsShutdown() {
  pinMode(PIN_AMP_L_SD, OUTPUT);
  pinMode(PIN_AMP_R_SD, OUTPUT);
  digitalWrite(PIN_AMP_L_SD, LOW);
  digitalWrite(PIN_AMP_R_SD, LOW);
}

static void ampsOn() {
  if (!soundOn) return ampsShutdown();
  pinMode(PIN_AMP_L_SD, INPUT);
  pinMode(PIN_AMP_R_SD, INPUT);
  if (ampSleep) vTaskDelay(pdMS_TO_TICKS(10));  // wake-up time
}

static void ampsOff() {
  if (!ampSleep) return ampsOn();
  ampsShutdown();
}

// ---------- I2S ----------
static void applyPins() {
  i2s_pin_config_t p = {};
  p.mck_io_num = I2S_PIN_NO_CHANGE;
  p.bck_io_num = pinBclk;
  p.ws_io_num = pinLrc;
  p.data_out_num = pinDin;
  p.data_in_num = I2S_PIN_NO_CHANGE;
  i2s_set_pin(PORT, &p);
}

static void i2sInit() {
  i2s_config_t c = {};
  c.mode = (i2s_mode_t)(I2S_MODE_MASTER | I2S_MODE_TX);
  c.sample_rate = 22050;
  c.bits_per_sample = I2S_BITS_PER_SAMPLE_16BIT;
  c.channel_format = I2S_CHANNEL_FMT_RIGHT_LEFT;
  c.communication_format = I2S_COMM_FORMAT_STAND_I2S;
  c.dma_buf_count = DMA_BUFS;
  c.dma_buf_len = DMA_LEN;
  c.tx_desc_auto_clear = true;  // output silence on underrun
  i2s_driver_install(PORT, &c, 0, nullptr);

  applyPins();
  i2s_zero_dma_buffer(PORT);
  i2s_stop(PORT);  // amp sleeps (silent) while there are no clocks
  currentRate = 22050;
}

static void setRate(uint32_t rate) {
  if (rate == currentRate) return;
  i2s_set_clk(PORT, rate, I2S_BITS_PER_SAMPLE_16BIT, I2S_CHANNEL_STEREO);
  currentRate = rate;
}

// Mono samples -> stereo frames with volume applied, blocking write.
// When the last block with real sound went out, and how long after that it
// can still be heard (the DMA buffers plus a little room echo).
static volatile uint32_t lastSoundMs = 0;
static volatile uint32_t audibleTailMs = 0;
static const int SOUND_LEVEL = 300;  // about -40 dBFS
static const int ROOM_ECHO_MS = 120;

// A small speaker can't play deep bass: the cone only swings further, hits
// something and buzzes. Two cascaded biquads = 4th-order Butterworth high-pass.
static volatile int bassCutHz = 250;  // 0 = off
struct Biquad {
  float b0, b1, b2, a1, a2, z1 = 0, z2 = 0;
  float run(float x) {
    float y = b0 * x + z1;
    z1 = b1 * x - a1 * y + z2;
    z2 = b2 * x - a2 * y;
    return y;
  }
};
static Biquad highPass[2];
static uint32_t highPassRate = 0;
static int highPassHz = -1;

static void updateHighPass() {
  if (highPassRate == currentRate && highPassHz == bassCutHz) return;
  highPassRate = currentRate;
  highPassHz = bassCutHz;
  if (highPassHz <= 0 || !highPassRate) return;
  const float q[2] = {0.5412f, 1.3066f};
  float w = 2 * PI * highPassHz / highPassRate, c = cosf(w);
  for (int k = 0; k < 2; k++) {
    float alpha = sinf(w) / (2 * q[k]), a0 = 1 + alpha;
    Biquad &f = highPass[k];
    f.b0 = f.b2 = (1 + c) / 2 / a0;
    f.b1 = -(1 + c) / a0;
    f.a1 = -2 * c / a0;
    f.a2 = (1 - alpha) / a0;
    f.z1 = f.z2 = 0;
  }
}

// Echo: a feedback delay, so each repeat is softer than the last.
static volatile bool echoOn = false;
static volatile int echoPct = 30;
static volatile int echoDelayMs = 250;
static const int ECHO_MAX_MS = 600;
static float *echoBuf = nullptr;  // PSRAM, ECHO_MAX_MS at 48 kHz
static int echoPos = 0;

static void echoClear() {
  if (echoBuf) memset(echoBuf, 0, ECHO_MAX_MS * 48 * sizeof(float));
  echoPos = 0;
}

// How long the repeats stay audible (to about -40 dB), to let them ring out.
static int echoTailMs() {
  if (!echoOn || echoPct <= 0) return 0;
  float g = echoPct / 100.0f, fb = g * 0.6f;
  int repeats = 1 + (int)ceilf(logf(0.01f / g) / logf(fb));
  return min(repeats * echoDelayMs, 3000);
}

static void writeMono(const int16_t *s, int n) {
  static int16_t frames[2 * 480];
  int v = vol;
  bool sound = false;
  updateHighPass();
  bool filter = highPassHz > 0;
  float g = echoBuf && echoOn ? echoPct / 100.0f : 0, fb = g * 0.6f;
  int len = constrain(echoDelayMs * (int)currentRate / 1000, 1, ECHO_MAX_MS * 48);
  float headroom = 1 / (1 + 0.5f * g);
  for (int i = 0; i < n; i++) {
    float y = filter ? highPass[1].run(highPass[0].run(s[i])) : s[i];
    if (g > 0) {
      if (echoPos >= len) echoPos = 0;
      float d = echoBuf[echoPos];
      echoBuf[echoPos++] = y + fb * d;
      y = (y + g * d) * headroom;
    }
    int16_t x = constrain((int32_t)(y * v / 100), -32768, 32767);
    frames[2 * i] = frames[2 * i + 1] = x;
    if (x > SOUND_LEVEL || x < -SOUND_LEVEL) sound = true;
  }
  if (sound) lastSoundMs = millis();
  size_t written;
  i2s_write(PORT, frames, n * 4, &written, portMAX_DELAY);
}

// ---------- WAV ----------
// Light cues stored in the WAV itself (chunk "fxcu", lines "<ms> <effect>",
// written by tools/make_cues.py), so a clip brings its own candle and eye
// effects wherever it is played from.
struct Cue {
  uint32_t ms;
  char name[16];
};
static const int MAX_CUES = 24;
static void (*cueHandler)(const char *name) = nullptr;
// How much earlier a cue must fire (ms), e.g. the smoke machine's delay.
static int (*cueLead)(const char *name) = nullptr;
static int leadOf(const Cue &c) { return cueLead ? constrain(cueLead(c.name), 0, 3000) : 0; }

struct WavInfo {
  uint32_t rate;
  uint16_t channels;
  uint32_t dataLen;
  Cue cues[MAX_CUES];
  int nCues = 0;
};

static void readCues(File &f, uint32_t len, WavInfo &w) {
  String text;
  text.reserve(len);
  for (uint32_t i = 0; i < len && i < 1024; i++) text += (char)f.read();
  int at = 0;
  while (at < (int)text.length() && w.nCues < MAX_CUES) {
    int nl = text.indexOf('\n', at);
    if (nl < 0) nl = text.length();
    String line = text.substring(at, nl);
    at = nl + 1;
    int sp = line.indexOf(' ');
    if (sp <= 0) continue;
    Cue &c = w.cues[w.nCues++];
    c.ms = line.substring(0, sp).toInt();
    line.substring(sp + 1).trim();
    strlcpy(c.name, line.substring(sp + 1).c_str(), sizeof(c.name));
  }
}

static bool readWavHeader(File &f, WavInfo &w) {
  char id[4];
  uint32_t len;
  if (f.read((uint8_t *)id, 4) != 4 || memcmp(id, "RIFF", 4)) return false;
  f.read((uint8_t *)&len, 4);
  if (f.read((uint8_t *)id, 4) != 4 || memcmp(id, "WAVE", 4)) return false;
  bool haveFmt = false;
  while (f.read((uint8_t *)id, 4) == 4 && f.read((uint8_t *)&len, 4) == 4) {
    if (!memcmp(id, "fmt ", 4)) {
      uint16_t fmt, bits;
      f.read((uint8_t *)&fmt, 2);
      f.read((uint8_t *)&w.channels, 2);
      f.read((uint8_t *)&w.rate, 4);
      f.seek(f.position() + 6);  // byte rate + block align
      f.read((uint8_t *)&bits, 2);
      f.seek(f.position() + (len - 16));
      if (fmt != 1 || bits != 16 || w.channels < 1 || w.channels > 2) {
        Serial.printf("WAV: need 16-bit PCM mono/stereo (fmt=%u bits=%u ch=%u)\n",
                      fmt, bits, w.channels);
        return false;
      }
      haveFmt = true;
    } else if (!memcmp(id, "data", 4)) {
      w.dataLen = len;
      return haveFmt;
    } else if (!memcmp(id, "fxcu", 4)) {
      uint32_t next = f.position() + len + (len & 1);
      readCues(f, len, w);
      f.seek(next);
    } else {
      f.seek(f.position() + len + (len & 1));
    }
  }
  return false;
}

// ---------- playback ----------
static void synthTone() {
  const uint32_t rate = 22050;
  const int blockN = rate / 100;
  setRate(rate);
  Serial.printf("Test tone (BCLK=%d LRC=%d DIN=%d)\n", pinBclk, pinLrc, pinDin);
  int16_t buf[rate / 100];
  Envelope env;
  env.reset();
  uint32_t t = 0;
  for (int b = 0; b < 300 && !stopFlag; b++) {
    bool on = (b / 20) % 2 == 0;
    for (int i = 0; i < blockN; i++, t++)
      buf[i] = on ? (int16_t)(12000 * sinf(2 * PI * 440 * t / rate)) : 0;
    jaw::setTarget(env.update(buf, blockN));
    writeMono(buf, blockN);
  }
  i2s_zero_dma_buffer(PORT);
  jaw::setTarget(0);
}

// A source yields mono 16-bit samples: read() returns how many it wrote
// (padding with silence is fine), or -1 when it has ended.
struct Source {
  virtual ~Source() {}
  virtual uint32_t rate() = 0;
  virtual int read(int16_t *mono, int n) = 0;
  virtual const Cue *cues(int &n) {
    n = 0;
    return nullptr;
  }
};

struct FileSource : Source {
  File f;
  WavInfo w;
  uint32_t remaining = 0;
  int16_t *raw = nullptr;
  bool open(const String &path, int maxN) {
    f = storage::clips().open(path, "r");
    if (!f || !readWavHeader(f, w) || w.rate > 48000) return false;
    remaining = w.dataLen;
    raw = (int16_t *)malloc(maxN * 2 * w.channels);
    Serial.printf("Playing %s (%u Hz, %u ch, %.1fs)\n", path.c_str(), w.rate,
                  w.channels, w.dataLen / (2.0f * w.channels * w.rate));
    return true;
  }
  ~FileSource() {
    f.close();
    free(raw);
  }
  uint32_t rate() override { return w.rate; }
  const Cue *cues(int &n) override {
    n = w.nCues;
    return w.cues;
  }
  int read(int16_t *mono, int n) override {
    if (!remaining) return -1;
    int want = min<uint32_t>(n * 2 * w.channels, remaining);
    int got = f.read((uint8_t *)raw, want);
    remaining = got > 0 ? remaining - got : 0;
    int m = got / (2 * w.channels);
    for (int i = 0; i < m; i++)
      mono[i] = w.channels == 2 ? (raw[2 * i] + raw[2 * i + 1]) / 2 : raw[i];
    return m ? m : -1;
  }
};

// ---------- live stream (fed by UDP packets) ----------
// Single producer (UDP task) / single consumer (audio task) ring buffer.
static const int LIVE_RING = LIVE_RATE;          // 1 s
static const int LIVE_PREBUFFER = LIVE_RATE / 10;  // 100 ms cushion for WiFi jitter
static const int LIVE_MAX_FILL = LIVE_RATE * 2 / 5;  // trim latency above 400 ms
static const uint32_t LIVE_IDLE_END_MS = 1500;
static int16_t *liveRing = nullptr;
static volatile uint32_t liveHead = 0, liveTail = 0;  // free-running counters
static volatile uint32_t lastPacketMs = 0;
static volatile bool liveActive = false;

struct LiveSource : Source {
  bool buffering = true;
  uint32_t rate() override { return LIVE_RATE; }
  int read(int16_t *mono, int n) override {
    uint32_t fill = liveHead - liveTail;
    if (fill > LIVE_MAX_FILL) liveTail = liveHead - LIVE_PREBUFFER;  // catch up
    if (buffering && fill >= LIVE_PREBUFFER) buffering = false;
    if (buffering || fill < (uint32_t)n) {
      buffering = true;  // underrun: play silence until we have a cushion again
      memset(mono, 0, n * 2);
      if (millis() - lastPacketMs > LIVE_IDLE_END_MS) return -1;
      return n;
    }
    uint32_t t = liveTail;
    for (int i = 0; i < n; i++) mono[i] = liveRing[(t + i) % LIVE_RING];
    liveTail = t + n;
    return n;
  }
};

// Packets: 'S','K', uint16 seq (LE), then int16 LE mono samples at LIVE_RATE.
static AsyncUDP udp;
static uint16_t lastSeq = 0;

static void onLivePacket(AsyncUDPPacket &p) {
  const uint8_t *d = p.data();
  size_t len = p.length();
  if (len < 6 || d[0] != 'S' || d[1] != 'K') return;
  uint16_t seq = d[2] | (d[3] << 8);
  if (!liveActive) {  // first packet of a new session
    liveHead = liveTail = 0;
    lastSeq = seq - 1;
    lastPacketMs = millis();
    liveActive = true;
    playFile("@live");
  } else if ((int16_t)(seq - lastSeq) <= 0) {
    return;  // duplicate or out of order
  }
  lastSeq = seq;
  lastPacketMs = millis();
  int n = (len - 4) / 2;
  uint32_t h = liveHead;
  if (h - liveTail + n > (uint32_t)LIVE_RING) return;  // full: drop packet
  for (int i = 0; i < n; i++) {
    int16_t v;
    memcpy(&v, d + 4 + 2 * i, 2);
    liveRing[(h + i) % LIVE_RING] = v;
  }
  liveHead = h + n;
}

// Plays any source through the jaw-sync pipeline. mouth=false: sound effects
// (fx_*.wav, a ticking clock) leave the jaw and everything following it still.
static void playSource(Source &src, bool mouth = true) {
  const uint32_t rate = src.rate();
  setRate(rate);
  const int blockN = rate / 100;  // 10 ms of samples
  const int dmaMs = DMA_BUFS * DMA_LEN * 1000 / rate;
  const int leadBlocks =
      constrain((cfg.leadMs - dmaMs) / 10, 0, MAX_LEAD_BLOCKS);
  audibleTailMs = dmaMs + ROOM_ECHO_MS;

  // Delay line: audio sits here `leadBlocks` blocks while the jaw already
  // moves, compensating for the servo's mechanical lag.
  int16_t *ring = (int16_t *)ps_calloc((leadBlocks + 1) * blockN, 2);
  int head = 0, filled = 0;
  Envelope env;
  env.reset();

  echoClear();
  int nCues;
  const Cue *cues = src.cues(nCues);
  bool fired[MAX_CUES] = {};
  auto fireDue = [&](int32_t t) {  // t: ms into the clip, as heard
    for (int i = 0; i < nCues; i++)
      if (!fired[i] && (int32_t)cues[i].ms - leadOf(cues[i]) <= t) {
        fired[i] = true;
        if (cueHandler) cueHandler(cues[i].name);
      }
  };
  // A cue that needs a head start the clip doesn't have (smoke right at the
  // start): fire it, and let the sound wait.
  int32_t wait = 0;
  for (int i = 0; i < nCues; i++) wait = max(wait, (int32_t)leadOf(cues[i]) - (int32_t)cues[i].ms);
  for (int32_t t = -wait; t < 0 && !stopFlag; t += 10) {
    fireDue(t);
    vTaskDelay(pdMS_TO_TICKS(10));
  }
  uint32_t heardMs = 0;  // position of the block going to the speaker
  // Blocks still to flush from the ring after EOF, then the echo ringing out.
  int drain = leadBlocks + 1 + echoTailMs() / 10;
  bool ended = false;
  while (!stopFlag) {
    int16_t *mono = ring + head * blockN;
    int n = ended ? -1 : src.read(mono, blockN);
    if (n < 0) {
      ended = true;
      if (--drain < 0) break;
      n = 0;
    }
    if (n < blockN) memset(mono + n, 0, (blockN - n) * 2);  // pad / drain

    float open = env.update(mono, blockN);
    jaw::setTarget(ended || !mouth ? 0 : open);

    head = (head + 1) % (leadBlocks + 1);
    if (!ended) filled = min(filled + 1, leadBlocks + 1);
    if (filled > leadBlocks || ended) {
      writeMono(ring + head * blockN, blockN);  // oldest block
      heardMs += 10;
      fireDue(heardMs);
    }
  }
  free(ring);
  vTaskDelay(pdMS_TO_TICKS(dmaMs));
  i2s_zero_dma_buffer(PORT);
  jaw::setTarget(0);
}

// Sound effects are named fx_*.wav: no jaw, and not picked by "Spreek".
static bool isEffect(const String &path) {
  return path.substring(path.lastIndexOf('/') + 1).startsWith("fx_");
}

static void playOne(const String &path) {
  if (path == "@tone") return synthTone();
  if (path == "@live") {
    Serial.println("Live stream started");
    LiveSource live;
    playSource(live);
    liveActive = false;
    Serial.println("Live stream ended");
    return;
  }
  FileSource file;
  if (!file.open(path, 480)) {
    Serial.printf("Can't play %s\n", path.c_str());
    return;
  }
  playSource(file, !isEffect(path));
}

static void audioTask(void *) {
  for (;;) {
    ulTaskNotifyTake(pdTRUE, portMAX_DELAY);
    for (;;) {
      xSemaphoreTake(pathLock, portMAX_DELAY);
      String path = pendingPath;
      pendingPath = "";
      xSemaphoreGive(pathLock);
      if (!path.length()) break;
      stopFlag = false;
      xSemaphoreTake(pathLock, portMAX_DELAY);
      currentPath = path;
      xSemaphoreGive(pathLock);
      playing = true;
      ampsOn();
      i2s_start(PORT);
      playOne(path);
      xSemaphoreTake(pathLock, portMAX_DELAY);
      bool more = pendingPath.length();
      xSemaphoreGive(pathLock);
      if (!more) {
        i2s_stop(PORT);
        ampsOff();
      }
      playing = false;
    }
  }
}

void begin() {
  pathLock = xSemaphoreCreateMutex();
  prefs.begin("audio", false);
  vol = prefs.getInt("vol", 70);
  cfg.gate = prefs.getInt("gate", 400);
  cfg.sensitivity = prefs.getInt("sens", 60);
  cfg.leadMs = prefs.getInt("lead", 100);
  ampSleep = prefs.getBool("ampsleep", true);
  soundOn = prefs.getBool("soundon", true);
  bassCutHz = prefs.getInt("basscut", 250);
  echoOn = prefs.getBool("echoon", false);
  echoPct = prefs.getInt("echo", 30);
  echoDelayMs = prefs.getInt("echoms", 250);
  echoBuf = (float *)ps_calloc(ECHO_MAX_MS * 48, sizeof(float));
  pinBclk = prefs.getInt("bclk", PIN_I2S_BCLK);
  pinLrc = prefs.getInt("lrc", PIN_I2S_LRC);
  pinDin = prefs.getInt("din", PIN_I2S_DIN);

  ampsOff();
  i2sInit();
  xTaskCreatePinnedToCore(audioTask, "audio", 8192, nullptr, 5, &task, 1);

  liveRing = (int16_t *)ps_malloc(LIVE_RING * 2);
}

void beginNetwork() {
  if (udp.listen(LIVE_PORT)) udp.onPacket(onLivePacket);
}

bool playFile(const String &path) {
  if (path[0] != '@' && !storage::clips().exists(path)) return false;
  xSemaphoreTake(pathLock, portMAX_DELAY);
  pendingPath = path;
  xSemaphoreGive(pathLock);
  stopFlag = true;  // interrupt the current clip, if any
  xTaskNotifyGive(task);
  return true;
}

bool playRandom() {
  File dir = storage::clips().open("/clips");
  std::vector<String> names;
  for (File f = dir.openNextFile(); f; f = dir.openNextFile())
    // Not the effects, and not the clips that greet someone by name.
    if (String(f.name()).endsWith(".wav") && !isEffect(f.name()) && !String(f.name()).startsWith("naam_"))
      names.push_back(f.name());
  if (names.empty()) return false;
  static int last = -1;
  int i = random(names.size());
  if (names.size() > 1 && i == last) i = (i + 1) % names.size();
  last = i;
  return playFile("/clips/" + names[i]);
}

void playTone() { playFile("@tone"); }

void onCue(void (*handler)(const char *name), int (*leadMs)(const char *name)) {
  cueHandler = handler;
  cueLead = leadMs;
}

// A clip's light cues without its sound, on the clock instead of the audio.
static WavInfo silent;
static uint32_t silentStart = 0;
static bool silentFired[MAX_CUES];

bool lightsOnly(const String &path) {
  File f = storage::clips().open(path, "r");
  WavInfo w;
  if (!f || !readWavHeader(f, w) || !w.nCues) return false;
  silent = w;  // web handler and tickCues() both run in loop(): no lock
  silentStart = millis();
  memset(silentFired, 0, sizeof silentFired);
  return true;
}

void tickCues() {
  int32_t t = millis() - silentStart;
  for (int i = 0; i < silent.nCues; i++)
    if (!silentFired[i] && (int32_t)silent.cues[i].ms - leadOf(silent.cues[i]) <= t) {
      silentFired[i] = true;
      if (cueHandler) cueHandler(silent.cues[i].name);
    }
}

void setPins(int bclk, int lrc, int din) {
  pinBclk = bclk;
  pinLrc = lrc;
  pinDin = din;
  prefs.putInt("bclk", bclk);
  prefs.putInt("lrc", lrc);
  prefs.putInt("din", din);
  applyPins();
}

String pins() {
  return String("{\"bclk\":") + pinBclk + ",\"lrc\":" + pinLrc +
         ",\"din\":" + pinDin + "}";
}

void stop() { stopFlag = true; }
bool isPlaying() { return playing; }
bool isLive() { return liveActive; }
// "Playing" lasts until a live stream times out (LIVE_IDLE_END_MS after its
// last packet), but the mic only needs muting while sound is coming out.
bool isAudible() {
  return playing && millis() - lastSoundMs < audibleTailMs;
}

String currentClip() {
  if (!playing) return "";
  xSemaphoreTake(pathLock, portMAX_DELAY);
  String p = currentPath;
  xSemaphoreGive(pathLock);
  if (p[0] == '@') return "";  // tone / live
  return p.substring(p.lastIndexOf('/') + 1);
}

bool isValidWav(const String &path) {
  File f = storage::clips().open(path, "r");
  WavInfo w;
  bool ok = f && readWavHeader(f, w) && w.rate >= 8000 && w.rate <= 48000;
  f.close();
  return ok;
}

void setVolume(int p) {
  vol = constrain(p, 0, 100);
  prefs.putInt("vol", vol);
}
int volume() { return vol; }

void setAmpSleep(bool on) {
  ampSleep = on;
  prefs.putBool("ampsleep", on);
  if (!playing) ampsOff();  // applies right away (stays on if sleep is off)
}
bool ampSleepOn() { return ampSleep; }

void setSoundOn(bool on) {
  soundOn = on;
  prefs.putBool("soundon", on);
  if (playing) ampsOn();
  else ampsOff();
}
bool soundIsOn() { return soundOn; }

void setBassCut(int hz) {
  bassCutHz = constrain(hz, 0, 750);
  prefs.putInt("basscut", bassCutHz);
}
int bassCut() { return bassCutHz; }

void setEcho(bool on, int pct, int ms) {
  echoOn = on;
  echoPct = constrain(pct, 0, 80);
  prefs.putBool("echoon", on);
  echoDelayMs = constrain(ms, 50, ECHO_MAX_MS);
  prefs.putInt("echo", echoPct);
  prefs.putInt("echoms", echoDelayMs);
}
bool echoEnabled() { return echoOn; }
int echo() { return echoPct; }
int echoMs() { return echoDelayMs; }

Sync sync() { return cfg; }
void setSync(const Sync &s) {
  cfg.gate = constrain(s.gate, 0, 20000);
  cfg.sensitivity = constrain(s.sensitivity, 5, 100);
  cfg.leadMs = constrain(s.leadMs, 0, 400);
  prefs.putInt("gate", cfg.gate);
  prefs.putInt("sens", cfg.sensitivity);
  prefs.putInt("lead", cfg.leadMs);
}

}  // namespace audio
