carlmegens/knekelbeen/(commit log)

2026-10-13 Knekelbeen: talking Halloween skull (firmware, brain, PCB, case)
    Claude-Session: https://claude.ai/code/session_01DbmjsN5o9yMpgGQx4gkaxe
    [base.stl, case.scad, lid.stl, partitions.csv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]
2026-10-16 Add TinyTronics cart script, update parts list after assembly
    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
2026-10-16 Firmware: clips on microSD, jaw servo via LEDC
    With a card inserted at boot, /clips lives on the SD card (flash clips are
    copied over once and stay as a fallback). The skull page shows where the
    clips are and how much space is left.
    ESP32Servo hung the board as soon as the SD code was linked in, so the jaw
    now drives its servo pulses straight from LEDC.
    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
2026-10-17 Turn servo, PIR greeting, LED 2 and amp sleep, all switchable in settings
    - Turn servo on DRAAI (GPIO 8): center ± range with S-curve moves, released
    when resting, optional glancing around while talking. Off by default.
    - PIR on GPIO 2: flashes the eyes and bumps a counter; the laptop app polls
    it and a running Gemini session greets the visitors (a quiet conversation
    restarts fresh for a new group). Warm-up and cooldown, plus a test button.
    - LED 2 on GPIO 48: WS2812 LED or strip, follows the voice, on, flicker or off.
    - Amps sleep (shutdown pins 10/9 low) while nothing plays; can be switched off.
    - The app announces its LAN address instead of the VPN one.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
2026-10-17 Add turn, PIR, LED 2 and amp settings to the laptop page
    They were only on the skull's own page. The laptop page also shows free
    space in GB and whether clips live on the SD card.
    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
2026-10-21 Ease the jaw in and out, with an adjustable softness
    The jaw used a one-pole filter that started at full speed and slammed
    shut. It now follows a critically damped spring, closes 1.5x slower
    than it opens, and gets sub-degree pulses. Softness (0-80 ms) is a
    slider on both pages.
    Also fixes the space bar in the persona box on the laptop page: it
    started live talking instead of typing a space.
    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
    [audio.cpp, config.h, jaw.cpp, jaw.h, main.cpp]
2026-10-21 Add a design brief for the turning neck
    Measurements of the bearing, the servo and the spine, and how the parts
    should fit together, to hand to a Fusion 360 session.
    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
2026-10-21 Add the candle models (1.2 mm walls), made with ChatGPT
    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
    [kaars_D24_H60.step, kaars_D24_H60.stl, kaars_D24_H60_compleet.step, kaars_D24_H76.step, kaars_D24_H76.stl, kaars_D24_H76_compleet.step, kaars_D24_H89.step, kaars_D24_H89.stl]
2026-10-22 Make the AI answer reliably and listen again right after speaking
    - Effect tool: a SILENT response left the model mute when it called the
    effect before saying anything; use WHEN_IDLE then, SILENT only after speech.
    - Skull mic: mute only while sound is actually coming out (last loud block
    plus DMA and a little room echo), not until the live stream times out 1.5 s
    later. The laptop no longer adds its own 0.3 s on top.
    - Mic gate: 60 ms pre-roll so the soft start of a word gets through.
    - Voice, spooky effect, pitch and threshold now reach the AI that runs in the
    app (skull mic, phone), also mid-conversation, and are saved.
    Claud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
    [audio.cpp, audio.h, mic.cpp]
2026-10-23 Knekelbeen-stem voor AI-gesprekken, met opvulgeluidjes
    Gemini Live kent geen ontworpen stemmen, dus een eigen keten: spraakdetectie,
    gemini-3.5-flash-lite hoort de audio en antwoordt met tekst, stijl en effect,
    Gemini TTS streamt het antwoord in de ontworpen stem. Een kort 'Hmmm...' in
    dezelfde stem vult de ~3 s denktijd op.
    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
2026-10-23 Grap over buikpijn: bij de moppen en als clip
    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
2026-10-23 AI leert stijl van de clips; volume in de topbalk
    - Bij elk gesprek 12 willekeurige clipzinnen als stijlvoorbeeld, plus meer
    vrije hand om zelf dingen te verzinnen (moppen blijven uit de lijst)
    - Volume en Instellingen-knop in de topbalk van beide pagina's
    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
2026-10-23 Testscript voor de klokmicrofoon: ruis, spraak, storingen
    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
2026-10-25 Kinderstemmen: alleen Nederlands luisteren; adres-clip; radar met ESPHome
    - Gemini Live transcribeert vast in nl-NL met een Halloween-woordenlijst,
    in plaats van de taal te raden (kinderstemmen werden als andere taal gehoord)
    - Taalregel: het is altijd Nederlands, kinderen praten onduidelijk, kies de
    meest logische betekenis en zeg nooit dat het een andere taal is
    - Clip "adres" met griezelige lach
    - radar/: ESPHome-config voor de Seeed MR24HPC1-kit (wachtwoorden in de
    genegeerde secrets.yaml)
    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
2026-10-25 Draaiservo: vasthouden tijdens praten, geen schok bij weer aanzetten
    De servo liet na 0,6 s los; de draden duwden het hoofd dan weg en de
    volgende beweging schoot terug. Nu houdt hij vast zolang de schedel praat
    en laat pas na 3 s stilte los. Bij het opnieuw aanzetten krijgt hij eerst
    de goede stand en dan pas signaal.
    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
2026-10-25 Kaakservo: eerst de stand, dan pas signaal bij weer aanzetten
    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
2026-10-25 README: wat Knekelbeen is, hardware, mappen en aan de slag
    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
2026-10-25 README: foto van Knekelbeen in de klok
    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
2026-10-26 Nek: Fusion-ontwerp, STL's, schroeven en montage
    De draaiende nek zoals hij in de klok zit: een lazy susan van 72 mm op een
    geprinte base, een cap op de bovenste lagerplaat en de draaiservo ernaast,
    ondersteboven, met een arm en een pen in een sleuf. Servo +-30 graden is
    schedel +-25 graden. Het plateau rust op de servohouder (29,5 mm); de servo
    steekt erdoor.
    - nek/knekelbeen_nek.f3d en .step: het Fusion-ontwerp met parameters
    - nek/stl/: base, cap, servo-arm (asgat 4,8 mm, getest), afstandhouder voor
    de houten schijf (14,5 mm), vloerafstandhouders (29,5 mm) en een
    passingstest voor de servo-as
    - nek/README.md: printen, inserts, schroeven, montage en het draaibereik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
    [base.stl, cap.stl, knekelbeen_nek.f3d, knekelbeen_nek.step, schijf_afstandhouder_14_5mm.stl, servo_arm.stl, spline_fit_test.stl, vloer_afstandhouder_29_5mm.stl]
2026-10-26 Nek: geen kabeluitgang in de schijfafstandhouder
    De kabels uit de schedel gaan niet door de nek, dus de sleuf aan de
    onderkant van de afstandhouder kan weg. Het centreerrandje loopt nu
    helemaal rond.
    Claude-Session: https://claude.ai/code/session_012BY4GCbu5KyzKAeSHauAU3
    [knekelbeen_nek.f3d, knekelbeen_nek.step, schijf_afstandhouder_14_5mm.stl]
2026-10-26 Basfilter en echo voor het speakertje; schedelmodel in de README
    - Instelbaar hoogdoorlaatfilter (4e orde, standaard 250 Hz, max 750) tegen
    kraken van het kleine speakertje bij harde lage tonen
    - Echo op alles wat de schedel afspeelt: aan/uit, sterkte en galm, en de
    galm sterft uit na het einde van een clip
    - Beide in de schedelpagina en de laptop-app (echo onder Stem)
    - README: link naar het Printables-model met maker, licentie en maten
    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
2026-10-26 Adres-clip uit de repo: blijft alleen lokaal en op de SD-kaart
    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
2026-10-27 Aan/uit-schakelaars per groep; LED 2-effecten voor een ring
    - Elke groep (geluid, kaak, ogen, kaarsen, LED 2, draaiservo, bewegingssensor)
    heeft bovenaan een schuifschakelaar; uit maakt de instellingen eronder grijs
    en bewaart ze. Werkt meteen, in beide pagina's.
    - Firmware: aparte aan/uit voor ogen, kaarsen, LED 2, kaak (servo slap, lichten
    volgen de stem nog) en geluid (versterkers in shutdown). Een oude modus "Uit"
    wordt omgezet naar de schakelaar.
    - LED 2: flakkeren per ledje, en de nieuwe effecten Draaien en Stemmeter.
    - Echo en Spooky effect ook als schakelaar.
    Claude-Session: https://claude.ai/code/session_01DbmjsN5o9yMp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
2026-10-29 Camerabeeld bij de begroeting; bezoekers via Home Assistant
    - De begroeting gaat met een snapshot van de deurcamera naar Gemini Live,
    zodat hij meteen iets noemt van wat hij ziet.
    - brain/ha.py luistert via de WebSocket-API van HA naar de radar en de
    Frigate-persoonsensor in plaats van de PIR van de schedel op te vragen,
    met 60 s wachttijd na een begroeting.
    - Stem en Versterkers blijven op brede schermen één kolom breed.
    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
2026-10-30 Ogen kleuren mee met spookgroen; kaarsbedrading; testscript voor de kostuums
    - Bij het spookgroen-effect van de kaarsen worden de ogen 6 s hetzelfde
    groen; daarna weer hun eigen kleur (niet opgeslagen).
    - kaarsen/README.md: aansluiten op KAARSEN (wit = data, groen = klok).
    - tools/vision_test.py: de begroeting met camerabeeld testen met foto's,
    ook als zwart-wit nachtbeeld.
    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
2026-10-31 Lichteffecten in de clips; bezoekmodus, bliksem, rook en snoepschaal
    - Clips dragen hun eigen lichteffecten in een fxcu-chunk (tools/make_cues.py,
    clips/cues.txt); deurbel speelt die van het orgel zonder geluid
    - Bezoekmodus (PIR, Home Assistant, "Persoon testen"): kaarsen en LED 2
    gaan naar hun bezoekstand
    - Kaarseffecten één voor één; bliksem en rollende donder over kaarsen,
    ogen en LED 2
    - LED 2: rust/bezoek-standen, Ademen en Kaarsvlam, doet mee met effecten,
    snoepschaal die oplicht bij "trick or treat"
    - Rookmachine via Shelly (beetje/veel rook, wachttijd)
    - WS2801-frames in één keer verstuurd: geen flitsen meer tijdens audio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
2026-10-31 Rook bij boe met voorsprong; namen apart; scherp camerabeeld bij de begroeting
    - Rook bij "boe!" (AI en schrik-clip), buiten de gedeelde wachttijd
    - Instelbare voorsprong voor de rookmachine: cues vuren eerder, een clip
    met rook aan het begin wacht even
    - Clips met naam_ in een eigen blok Namen, nooit als willekeurige clip;
    blijven lokaal (.gitignore)
    - Begroeting: volle camerabeeld als dat binnen 1,2 s komt, anders het
    laatste Frigate-frame via Home Assistant
    - AI spreekt volwassenen niet meer als kinderen aan
    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
2026-10-31 Buitenlampen spelen mee; pompoenring op LED 2; camera zonder kleuren; instellingen bewaren
    - brain/lamps.py: de buitenlampen (Home Assistant) volgen het bezoek en de
    effecten van de schedel, met een rustige en een bezoek-stand per lamp
    - LED 2 in drie delen: bovenlicht, pompoen en snoepschaal
    - De schedel meldt het laatste lichteffect, zodat de lampen meedoen
    - Begroeting: geen kleuren noemen, het camerabeeld is 's nachts infrarood of roze
    - tools/settings.py: overzicht van alle instellingen, opslaan en terugzetten
    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
2026-11-01 Instellingen van Halloween 2026 bewaard
    tools/settings.py liet ook instellingen weg die net zo heten als live
    waarden (LED 2 count en fx); nu per pagina.
    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
